Meisterschulen-am-Ostbahnhof-Munchen/JC8012P4A1C_I_W_Y_CAN/pcbs/keypad/docs/folika_keypad_12.pdf

# Tastatur 2 x 6 - PU-Folie + 3 mm Plexiglas (PG)

für JC8012P4A1C_I_W_Y_CAN, Variante mit Tastatur - gleiches Prinzip wie FO SON PU 005 HOEPFINGER (4 Taster)

Maßstab 1:1 auf A4 (ohne Skalierung drucken), Maße in mm, Ansicht von vorne.
Kontur 48 x 150 mm, Eckradius 1,5 mm - Folie, Plexiglas und Platine haben dieselbe Kontur.
PU-Folie: bedruckt, Rückseite 3M 468MP, Klebefreiheit in den Tastenfeldern (14 x 14 mm), keine Löcher.
Plexiglasplatte 3 mm: Rückseite 3M 300LSE (dicker!), wird auf die Platine geklebt.
Ausschnitte im PG: 12 x 16,3 x 16,3 mm für die Taster (Taster 12 mm, vergrößert wg. Lötfahnen), mit Nase 5,8 x 1,45 mm (Diode),
4 x Ø 6,6 mm für die M2,5-SMD-Abstandshülsen der Platine (von der Folie verdeckt). Tastenraster 24 mm (Spalten) x 22,56 mm (Reihen). Gesamtdicke 5,5 mm (flacher Teil).
Druck wie FO SON PU 005: grauer Grund (2 mm Beschnitt), Tastenfelder 14 mm farbig mit 2 mm grauem Rahmen, Arial Bold schwarz. Tastennummern F1-F12 wie beim CCI 60: F1-F6 rechte Spalte, F7-F12 linke Spalte (neben dem Display), von oben nach unten.

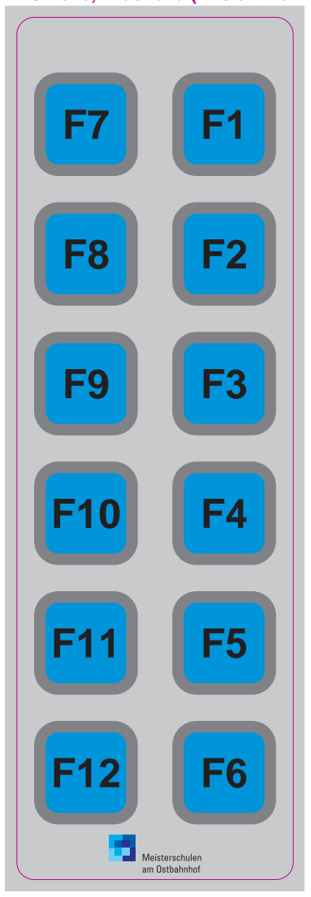
[picture p17: figure]

PU-Folie, Druckbild (Ansicht von vorne) | Plexiglas 3 mm (Ansicht von vorne)

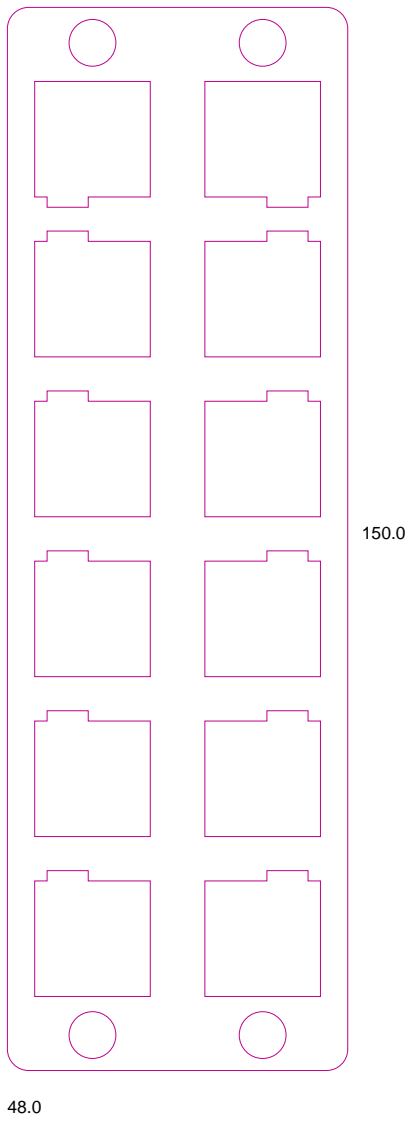
[picture p18: figure]

Mitten der Ausschnitte ab Tastaturmitte: x = ±12,0, y = ±11,28, ±33,84, ±56,40; Löcher Hülsen x = ±12,0, y = ±70,0
Nasen: Mitte 3,5 mm neben Tastenmitte zum Außenrand, bis 9,6 mm ab Tastenmitte; oberste Reihe unten, sonst oben
DXF mit derselben Geometrie: folika_keypad_12.dxf (Layer FOIL_OUTLINE, FOIL_KEY_FIELD_14, PG_OUTLINE, PG_CUT_POCKET, PG_CUT_HOLE_6_6)
