Meisterschulen-am-Ostbahnhof-Munchen/JC8012P4A1C_I_W_Y_CAN/pcbs/backplate_keypad/docs/backplate_outside.png

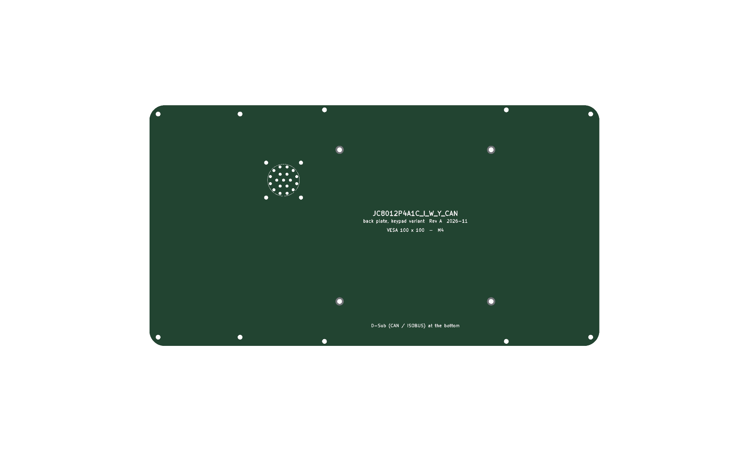
pcbs/backplate_keypad/docs/backplate_outside.png
