Meisterschulen-am-Ostbahnhof-Munchen/JC8012P4A1C_I_W_Y_CAN/pcbs/can_power/docs/board_3d_top.png

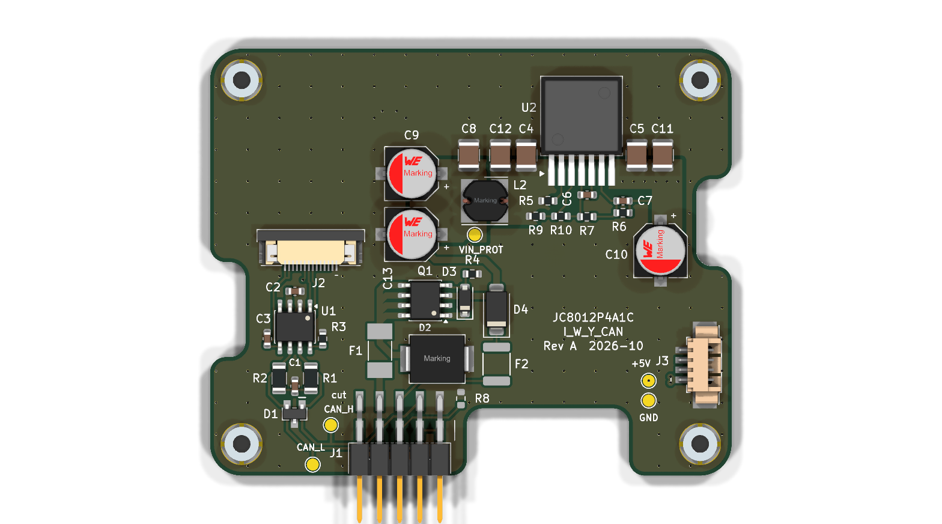
pcbs/can_power/docs/board_3d_top.png
