Meisterschulen-am-Ostbahnhof-Munchen/JC8012P4A1C_I_W_Y_CAN/mouser_order.csv

Mfr Part Number | Manufacturer | Qty per device | Order qty (5 devices + spares) | Description | Used for
MMSZ5245B_R1_00001 | Panjit | 1 | 6 | Zener diode 15 V SOD-123 | CAN board D3
B160-13-F | Diodes Incorporated | 1 | 6 | Schottky diode 60 V 1 A SMA | CAN board D4
0452001.MRL | Littelfuse | 1 | 6 | Fuse 1 A slow NANO2 | CAN board F1
MF-MSMF014-2 | Bourns | 1 | 6 | PTC fuse 0.14 A 60 V 1812 | CAN board F2
SI4948BEY-T1-E3 | Vishay | 1 | 6 | Dual P-MOSFET SO-8 | CAN board Q1
RC1206FR-07750RL | Yageo | 2 | 15 | Resistor 750 R 1 % 1206 | CAN board R1, R2
RC0603FR-0710KL | Yageo | 2 | 15 | Resistor 10 k 1 % 0603 | CAN board R3, R10
RC0603FR-07100KL | Yageo | 2 | 15 | Resistor 100 k 1 % 0603 | CAN board R4, R5
RC0603FR-075K62L | Yageo | 1 | 10 | Resistor 5k62 1 % 0603 | CAN board R6
RC0603FR-071K07L | Yageo | 1 | 10 | Resistor 1k07 1 % 0603 | CAN board R7
RC0603FR-0757K6L | Yageo | 1 | 10 | Resistor 57k6 1 % 0603 | CAN board R9
RC0603JR-070RL | Yageo | 0 | 10 | Resistor 0 R 0603 (optional) | CAN board R8, not fitted by default, only for harnesses that need TBC_GND
TLE9250VSJXUMA1 | Infineon | 1 | 6 | CAN transceiver SO-8 | CAN board U1
