Meisterschulen-am-Ostbahnhof-Munchen/JC8012P4A1C_I_W_Y_CAN/assembly_bom.csv

Pos | Qty | Part | Manufacturer | MPN | Note
1 | 4 | Screw M2x6 |  |  | addon board H1-H4 to display standoffs S1-S4, no washer (1.9 mm thread engagement in the 2.5 mm blind thread)
2 | 1 | FFC 14 pin, 0.5 mm pitch, 50 mm, type 2 (contacts on opposite sides) | Wurth Elektronik | 687714050002 | J2 to FPC3 EXTEND1 of the display board
3 | 1 | D-Sub 9 female, IDC for 1.27 mm ribbon cable, without nuts | Wurth Elektronik | 618009221923 | CAN cable, D-Sub side; from inside over the threads of the jackposts 7, fixed with the nuts 20. The shell is flush with the frame wall outside. Use the strain relief.
4 | 1 | IDC socket 2x5, 2.54 mm, with strain relief (WR-BHD) | Wurth Elektronik | 61201023021 | CAN cable, J1 side, position 10 closed with a coding plug
5 | 1 | Coding plug for IDC socket |  |  | closes position 10 (pin 10 of J1 is cut off)
6 | 1 | Ribbon cable 9 wire, 1.27 mm pitch, 28 AWG, 1 m piece | Wurth Elektronik | 63910915521CAB | CAN cable, length to be defined with the back plate; red wire = pin 1 on both ends, position 10 of the IDC socket stays empty (10 wire alternative: 63911015521CAB, then cut wire 10 short at the D-Sub)
7 | 2 | Jackpost (hex standoff) UNC 4-40 inner/outer, hex 5.0, thread 8.2, SW 4.5 (WA-HEX) | Wurth Elektronik | 94513200 | from outside into the 5 mm hex pockets of the frame wall, flush with the wall (1.0 mm wall under the hex). Glue them in with 2K epoxy (e.g. UHU plus endfest) on the side walls of the pocket only, not on the bottom (stays flush) and not into the female thread (screw a 4-40 screw in as a plug, wipe off at once); let it cure before the nuts 20 go on, then the bond takes most of the preload off the thin wall; takes the thumbscrews of the mating plug. Clamped length 4.76 mm (wall 1.0 + D-Sub flange 0.4 + body 3.0 + rivet collar 0.36), 3.4 mm of the thread in the nut 20. 94510000 (thread 5.0) and 94511000 (6.0) are too short.
8 | 8 | Thread forming screw for thermoplastics, WUEPLAST WN 1451, 3x10, pan head with flange (dk 6 mm), TX10 | Wurth | 4234 3 10 | back plate H5-H12 into the 2.4 mm pilot holes of the frame bosses (8.4 mm engagement)
9 | 6 | Screw M2.5x6 (original frame: M2.5x8) |  |  | frame to the brass posts of the display; with x6 only about 2 mm thread engagement unless the frame lugs get a counterbore
10 | 4 | Screw M4x12 |  |  | VESA 100 bracket to the M4 spacers of the back plate (bracket 1-3 mm thick)
11 | 2 | WR-WTB crimp housing 1.25 mm, 4 pin (female) | Wurth Elektronik | 653004113322 | 5 V cable: one on J3 of the addon board, one on CN2 of the display board
12 | 2 | WR-WTB pre-crimped wire 1.25 mm, contacts on both ends | Wurth Elektronik | 653153128130 | 5 V cable: one wire for pin 1 (+5V), one for pin 4 (GND), into the housings of pos. 11; 653100130115 does not fit (contact on one end only)
13 | 1 | Speaker 4 Ohm 3 W, 27.5 x 27.5 x 13 mm, cable 120 mm with 2-pin 1.25 mm plug |  | XHXDZ-2828 | LS1 on the inside of the back plate, membrane against the sound holes; plug into CN3 of the display board (top left corner seen from behind), cable through the opening of the display cover
14 | 4 | Screw M2.5x8 |  |  | speaker to the back plate, head outside; length depends on the thickness of the speaker lugs (to be measured)
15 | 4 | Nut M2.5 |  |  | speaker screws, inside
16 | 4 | Screw M2.5x8 |  |  | keypad variant only: keypad H1-H4 from behind through the 4 mm frame lugs and the PCB into the M2.5 spacers (2.4 mm thread). Never longer: an M2.5x10 pushes through the foil.
17 | 2 | Thread forming screw for thermoplastics, WUEPLAST WN 1451, 3x10 | Wurth | 4234 3 10 | keypad variant only: back plate H13/H14 in the corners of the keypad chamber (in addition to pos. 8)
18 | 1 | FFC 14 pin, 0.5 mm pitch, about 250 mm, type TBD | Wurth Elektronik |  | keypad variant only: keypad J1 to FPC4 EXTEND2 of the display board; length and type (contacts on the same / opposite sides) to be checked on the test print, pin 1 must end on pin 1
19 | 1 | PU foil printed + 3 mm plexiglass, 48 x 150 mm | Folika |  | keypad variant only: as FO SON PU 005 HOEPFINGER, drawing keypad/docs/folika_keypad_12.pdf
20 | 2 | Hex nut UNC 4-40, SW 4.5, 5 mm high (WA-HEX) | Wurth Elektronik | 94505009 | from inside onto the jackposts 7, clamps the D-Sub 3. Tighten only lightly (about 0.1 Nm): the 1.0 mm plastic wall under the jackpost hex takes the preload. Secure with locking lacquer (e.g. Loctite 7400) over nut and thread end, no liquid threadlocker (Loctite 2xx attacks ABS). Tighten with a socket SW 4.5 before the IDC cover and the strain relief are on, they are in the way of the socket; afterwards only an open-end wrench SW 4.5 fits)
