Meisterschulen-am-Ostbahnhof-Munchen/JC8012P4A1C_I_W_Y_CAN/pcbs/can_power/production/JC8012P4A1C_I_W_Y_CAN_bom.csv

Reference | Qty | Value | Manufacturer | MPN | Footprint | DNP
C1 | 1 | 47n | Wurth Elektronik | 885012206093 | Capacitor_SMD:C_0603_1608Metric
C2,C3 | 2 | 100n | Wurth Elektronik | 885012206095 | Capacitor_SMD:C_0603_1608Metric
C4,C12 | 2 | 10u/50V | Wurth Elektronik | 885012209073 | Capacitor_SMD:C_1210_3225Metric
C5,C11 | 2 | 47u/10V | Wurth Elektronik | 885012109007 | Capacitor_SMD:C_1210_3225Metric
C6,C7 | 2 | 22n | Wurth Elektronik | 885012206091 | Capacitor_SMD:C_0603_1608Metric
C8 | 1 | 1u/50V | Wurth Elektronik | 885012209047 | Capacitor_SMD:C_1210_3225Metric
C9,C13 | 2 | 22u/50V | Wurth Elektronik | 865080643008 | JC8012P4A1C_CAN:CP_Wurth_WCAP-ASLI-D6.3L5.5
C10 | 1 | 220u/10V | Wurth Elektronik | 875105244013 | JC8012P4A1C_CAN:CP_Wurth_WCAP-PSLP-D6.3L5.8
D1 | 1 | 824094024 | Wurth Elektronik | 824094024 | JC8012P4A1C_CAN:D_Wurth_WE-TVS-SOT23-3L
D2 | 1 | 824551241 | Wurth Elektronik | 824551241 | JC8012P4A1C_CAN:D_Wurth_WE-TVSP-DO214-AB-3000W_BI
D3 | 1 | 15V | Panjit | MMSZ5245B_R1_00001 | Diode_SMD:D_SOD-123
D4 | 1 | B160 | Diodes Incorporated | B160-13-F | Diode_SMD:D_SMA
F1 | 1 | 1A slow 125V | Littelfuse | 0452001.MRL | Fuse:Fuse_Littelfuse-NANO2-451_453
F2 | 1 | PTC 0.14A/60V | Bourns | MF-MSMF014-2 | Fuse:Fuse_1812_4532Metric
H1-H4 | 4 | Spacer M2 L2.5 | Wurth Elektronik | 9774025943R | JC8012P4A1C_CAN:A_Wurth_WA-SMST_9774025943R
J1 | 1 | 610110249121 | Wurth Elektronik | 610110249121 | JC8012P4A1C_CAN:J_Wurth_WR-PHD_610110249121
J2 | 1 | 68711414522 | Wurth Elektronik | 68711414522 | JC8012P4A1C_CAN:J_Wurth_WR-FPC_68711414522
J3 | 1 | 653104131822 | Wurth Elektronik | 653104131822 | JC8012P4A1C_CAN:J_Wurth_WR-WTB_653104131822
L2 | 1 | 10uH | Wurth Elektronik | 74477410 | JC8012P4A1C_CAN:L_Wurth_WE-PD2-5848
Q1 | 1 | Si4948BEY | Vishay | SI4948BEY-T1-E3 | Package_SO:SOIC-8_3.9x4.9mm_P1.27mm
R1,R2 | 2 | 750 1% | Yageo | RC1206FR-07750RL | Resistor_SMD:R_1206_3216Metric
R3,R10 | 2 | 10k 1% | Yageo | RC0603FR-0710KL | Resistor_SMD:R_0603_1608Metric
R4,R5 | 2 | 100k 1% | Yageo | RC0603FR-07100KL | Resistor_SMD:R_0603_1608Metric
R6 | 1 | 5k62 1% | Yageo | RC0603FR-075K62L | Resistor_SMD:R_0603_1608Metric
R7 | 1 | 1k07 1% | Yageo | RC0603FR-071K07L | Resistor_SMD:R_0603_1608Metric
R8 | 1 | 0R DNP | Yageo | RC0603JR-070RL | Resistor_SMD:R_0603_1608Metric | Nicht bestücken
R9 | 1 | 57k6 1% | Yageo | RC0603FR-0757K6L | Resistor_SMD:R_0603_1608Metric
U1 | 1 | TLE9250VSJ | Infineon | TLE9250VSJXUMA1 | Package_SO:SOIC-8_3.9x4.9mm_P1.27mm
U2 | 1 | 171030601 | Wurth Elektronik | 171030601 | JC8012P4A1C_CAN:U_Wurth_WPME-VDRM-TO263-7EP
