Meisterschulen-am-Ostbahnhof-Munchen/JC8012P4A1C_I_W_Y_CAN/pcbs/keypad/production/JC8012P4A1C_keypad_bom.csv

Reference | Qty | Value | Manufacturer | MPN | Footprint | DNP
D1-D12 | 12 | BAT43W | Panjit | BAT43W_R1_00001 | Diode_SMD:D_SOD-123
H1-H4 | 4 | Spacer M2.5 L3 | Wurth Elektronik | 9774030151R | Keypad:A_Wurth_WA-SMSI_9774030151R
J1 | 1 | 68711414522 | Wurth Elektronik | 68711414522 | Keypad:J_Wurth_WR-FPC_68711414522
S1-S12 | 12 | 430162043826 | Wurth Elektronik | 430162043826 | Keypad:SW_Wurth_WS-TASV_430162043826
