Meisterschulen-am-Ostbahnhof-Munchen/JC8012P4A1C_I_W_Y_CAN/pcbs/backplate/production/JC8012P4A1C_backplate_bom.csv

Reference | Qty | Value | Manufacturer | MPN | Footprint | DNP
H1-H4 | 4 | Spacer M4 L10 | Wurth Elektronik | 9774100482R | Backplate:A_Wurth_WA-SMSI_9774100482R
