Meisterschulen-am-Ostbahnhof-Munchen/JC8012P4A1C_I_W_Y_CAN/assembly/JC8012P4A1C_assembly_variant2_keypad.step

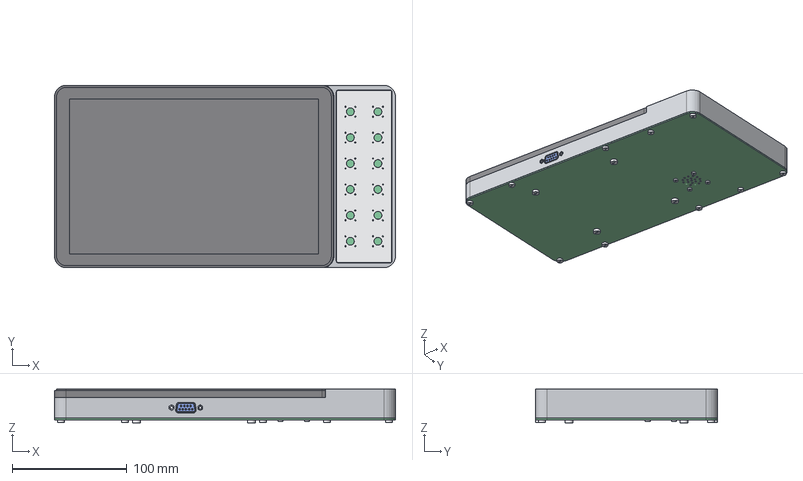
[picture p23: CAD file, 2026-11-13]
assembly/JC8012P4A1C_assembly_variant2_keypad.step
296.9 x 158.7 x 29.2 mm
A Display Guition JC8012P4A1C (envelope)
C Frame with keypad chamber
3 D-Sub 9 female (618009221923)
7 Jackpost (94513200)
20 Hex nut UNC 4-40 (94505009)
9 Screw M2.5x6
D Back plate PCB
13 Speaker 4 Ohm 3 W (XHXDZ-2828)
15 Nut M2.5
14 Screw M2.5x8
8 Thread forming screw for thermoplastics (4234 3 10)
10 Screw M4x12
B CAN addon board
1 Screw M2x6
E Keypad PCB
19 PU foil printed + 3 mm plexiglass
19 PU foil, printed (Folika)
16 Screw M2.5x8
17 Thread forming screw for thermoplastics (4234 3 10)
