Meisterschulen-am-Ostbahnhof-Munchen/JC8012P4A1C_I_W_Y_CAN/assembly/models/D-Sub_Wurth_618009221923.step

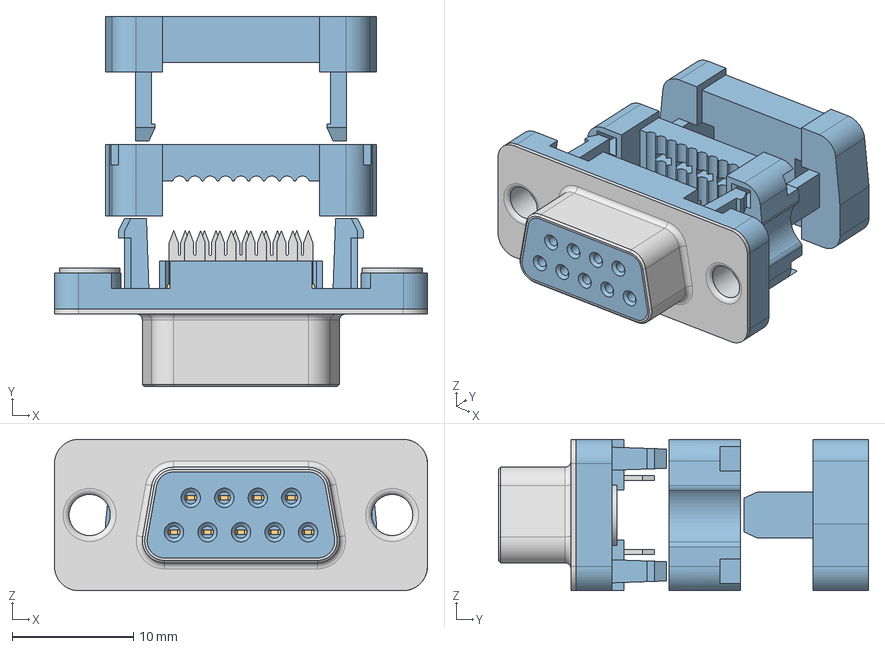
[picture p24: CAD file, 2026-11-13]
assembly/models/D-Sub_Wurth_618009221923.step
30.8 x 30.6 x 12.5 mm
6180xx221923_PIN
6180xx221923_PIN02
6180xx221923_PIN04
61800922x923_Pad
6180xx221923_PIN05
6180xx221923_Rivet x 2
6180xx221923_PIN03
6180xx221923_PIN20
6180xx221923_PIN21
6180xx221923_PIN22
6180xx221923_PIN23
61800922x923_Strain Relief
