Meisterschulen-am-Ostbahnhof-Munchen/JC8012P4A1C_I_W_Y_CAN/mechanics/frame.step

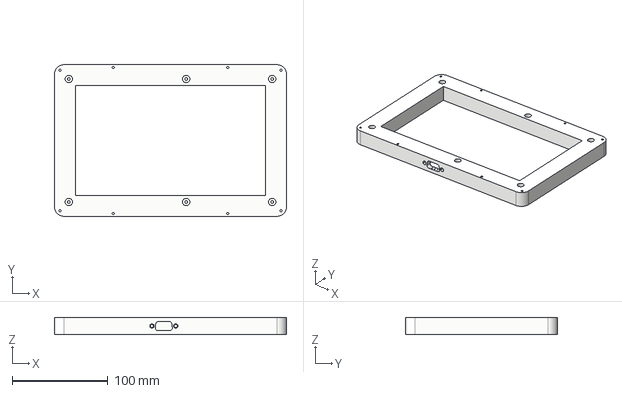
[picture p25: CAD file, 2026-11-13]
mechanics/frame.step
242.8 x 158.7 x 18.0 mm
