Meisterschulen-am-Ostbahnhof-Munchen/JC8012P4A1C_I_W_Y_CAN/mechanics/source/guition_mount-landscape.step

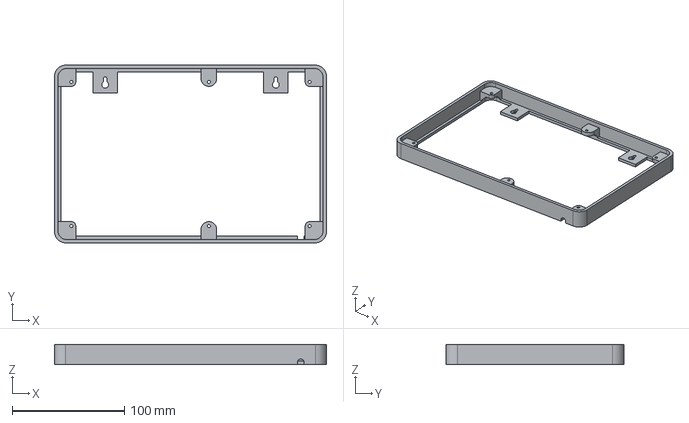
[picture p26: CAD file, 2026-11-01]
mechanics/source/guition_mount-landscape.step
242.8 x 158.7 x 18.0 mm
