Meisterschulen-am-Ostbahnhof-Munchen/JC8012P4A1C_I_W_Y_CAN/pcbs/keypad/docs/folika_keypad_12.dxf

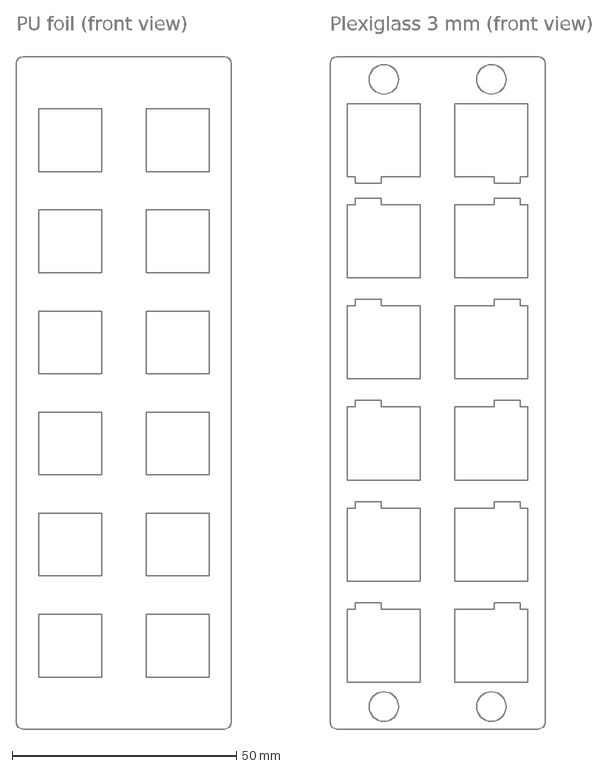
[picture p27: CAD file, 2026-11-03]
pcbs/keypad/docs/folika_keypad_12.dxf
PU foil (front view)
Plexiglass 3 mm (front view)
