Meisterschulen-am-Ostbahnhof-Munchen/JC8012P4A1C_I_W_Y_CAN/assembly/models/HexNut_Wurth_94505009.step

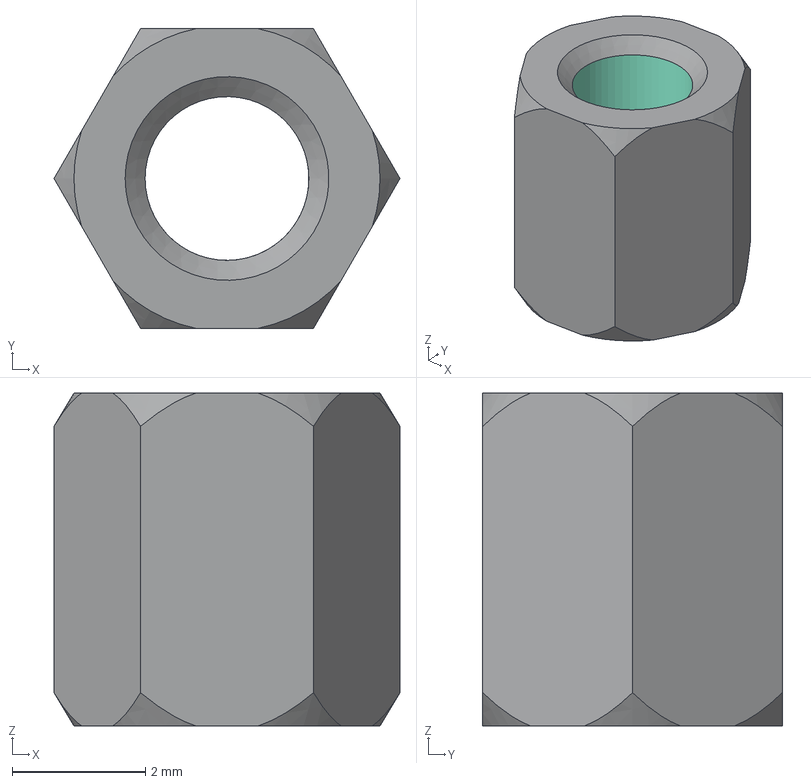
[picture p28: CAD file, 2026-11-13]
assembly/models/HexNut_Wurth_94505009.step
5.20 x 4.50 x 5.00 mm
