Meisterschulen-am-Ostbahnhof-Munchen/JC8012P4A1C_I_W_Y_CAN/mechanics/frame_keypad.step

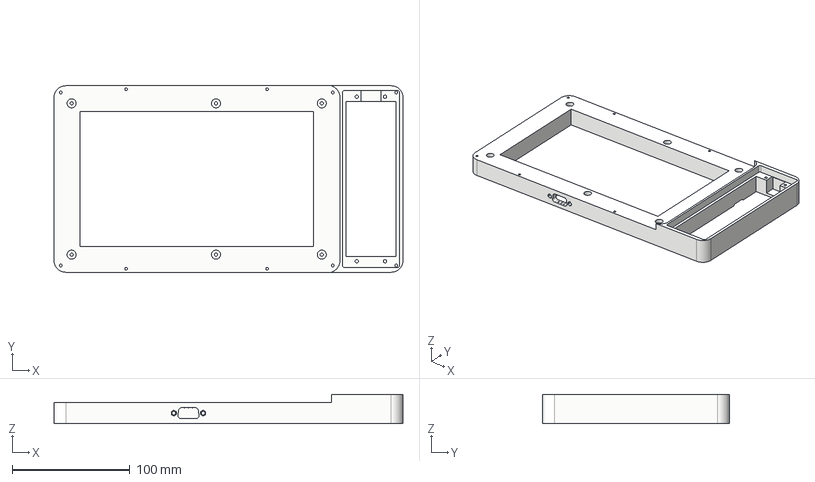
[picture p29: CAD file, 2026-11-13]
mechanics/frame_keypad.step
296.9 x 158.7 x 25.0 mm
