Meisterschulen-am-Ostbahnhof-Munchen/JC8012P4A1C_I_W_Y_CAN/assembly/models/Jackpost_Wurth_94513200.step

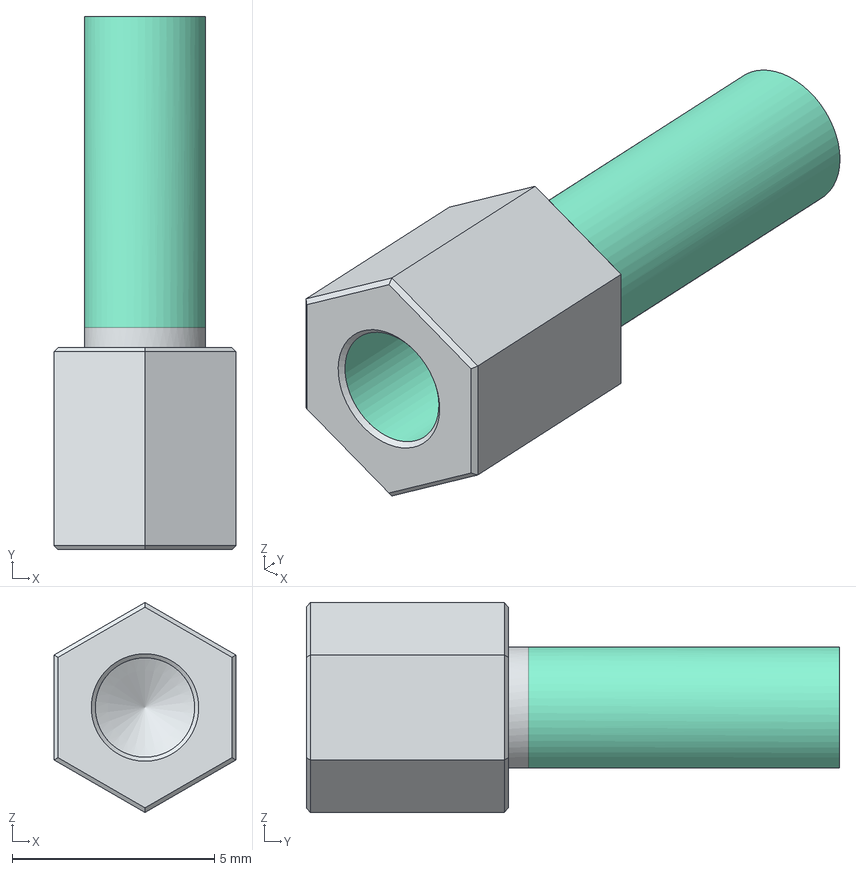
[picture p30: CAD file, 2026-11-13]
assembly/models/Jackpost_Wurth_94513200.step
4.50 x 13.2 x 5.20 mm
