Meisterschulen-am-Ostbahnhof-Munchen/JC8012P4A1C_I_W_Y_CAN/assembly/models/Jackpost_Wurth_94510000.step

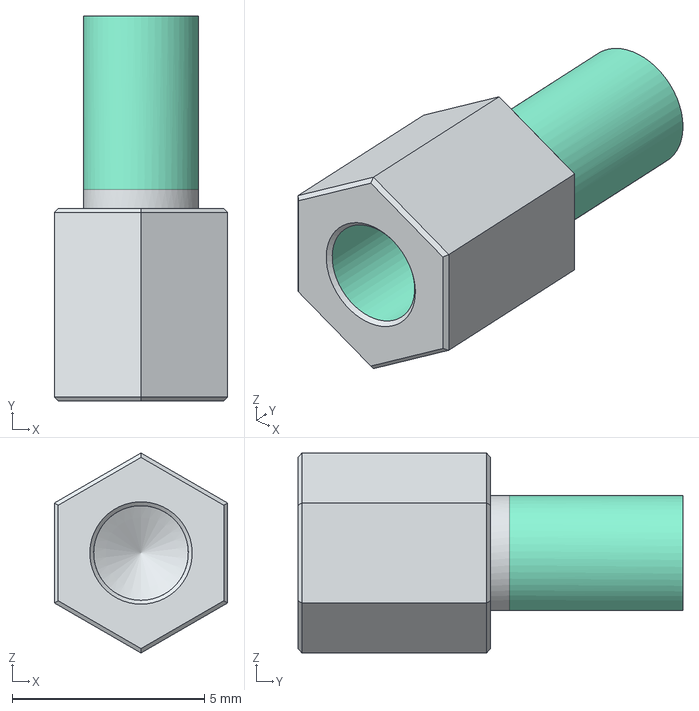
[picture p31: CAD file, 2026-11-03]
assembly/models/Jackpost_Wurth_94510000.step
4.50 x 10.0 x 5.20 mm
