Meisterschulen-am-Ostbahnhof-Munchen/JC8012P4A1C_I_W_Y_CAN/assembly/models/JC8012P4A1_envelope.step

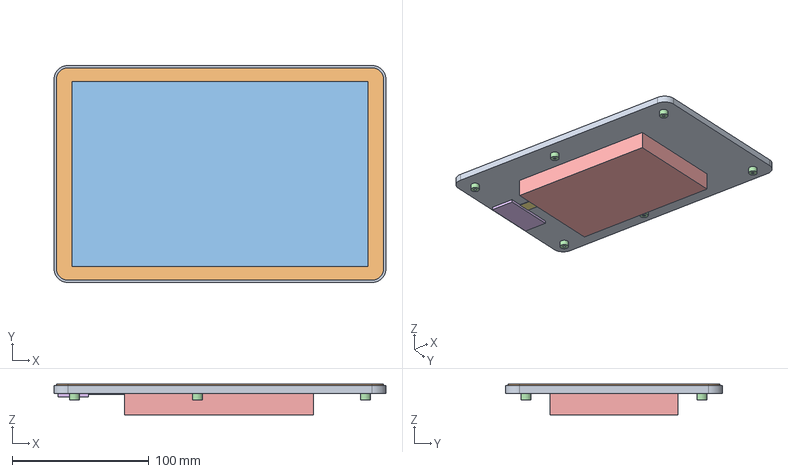
[picture p32: CAD file, 2026-11-03]
assembly/models/JC8012P4A1_envelope.step
242.8 x 158.7 x 22.5 mm
Frame
CoverGlass
LCD_ActiveArea
Bosses
BackHousing
ConnectorBlock
FlatCable
