Meisterschulen-am-Ostbahnhof-Munchen/JC8012P4A1C_I_W_Y_CAN/(list of files, cad)

Other CAD files:
mechanics/frame.f3d
mechanics/frame.stl
mechanics/frame_keypad.f3d
mechanics/frame_keypad.stl
