Meisterschulen-am-Ostbahnhof-Munchen/JC8012P4A1C_I_W_Y_CAN/assembly/img/variant1_assembled_front.png

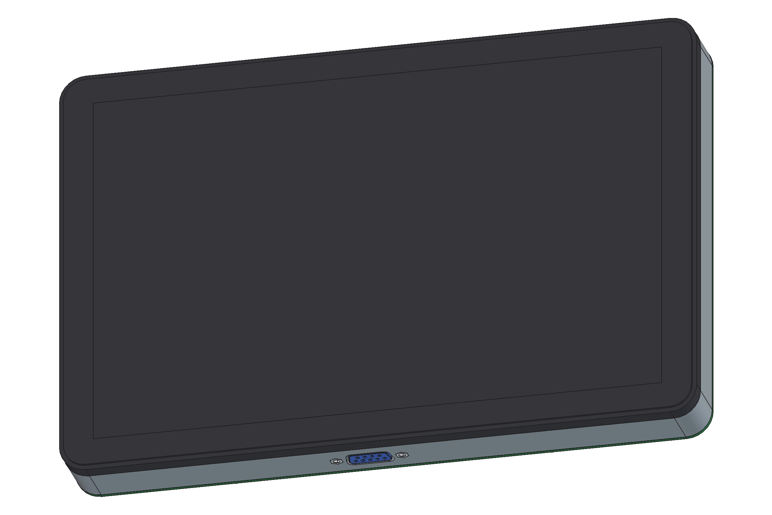
assembly/img/variant1_assembled_front.png
