Meisterschulen-am-Ostbahnhof-Munchen/JC8012P4A1C_I_W_Y_CAN/assembly/img/variant1_exploded_back.png

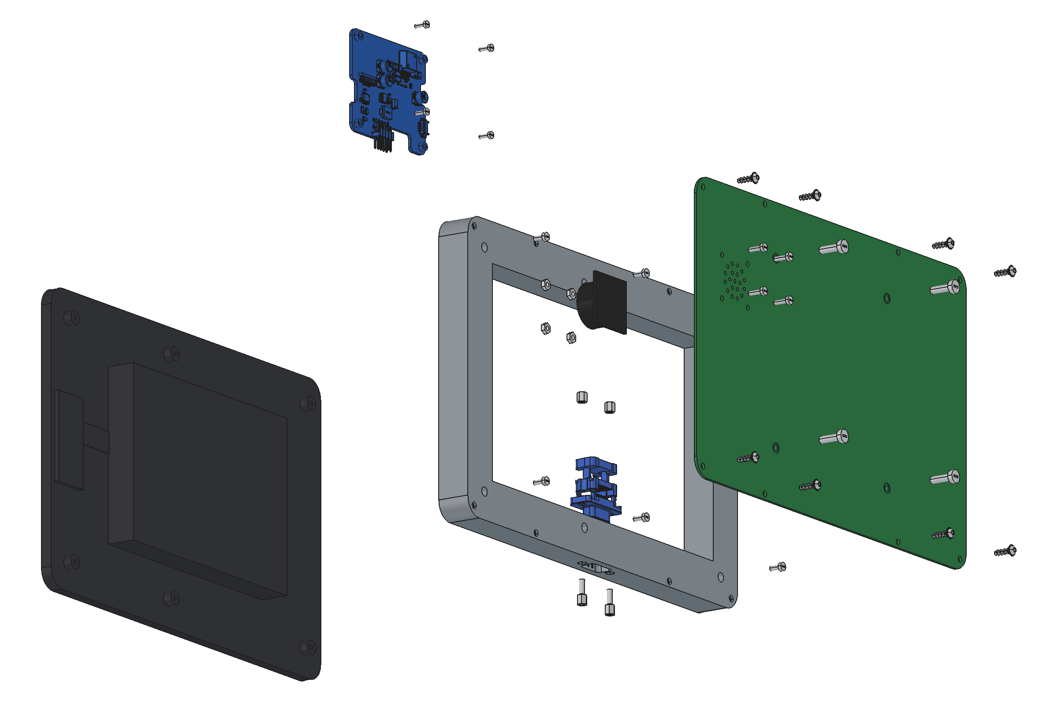
assembly/img/variant1_exploded_back.png
