Meisterschulen-am-Ostbahnhof-Munchen/JC8012P4A1C_I_W_Y_CAN/assembly/img/variant2_assembled_front.png

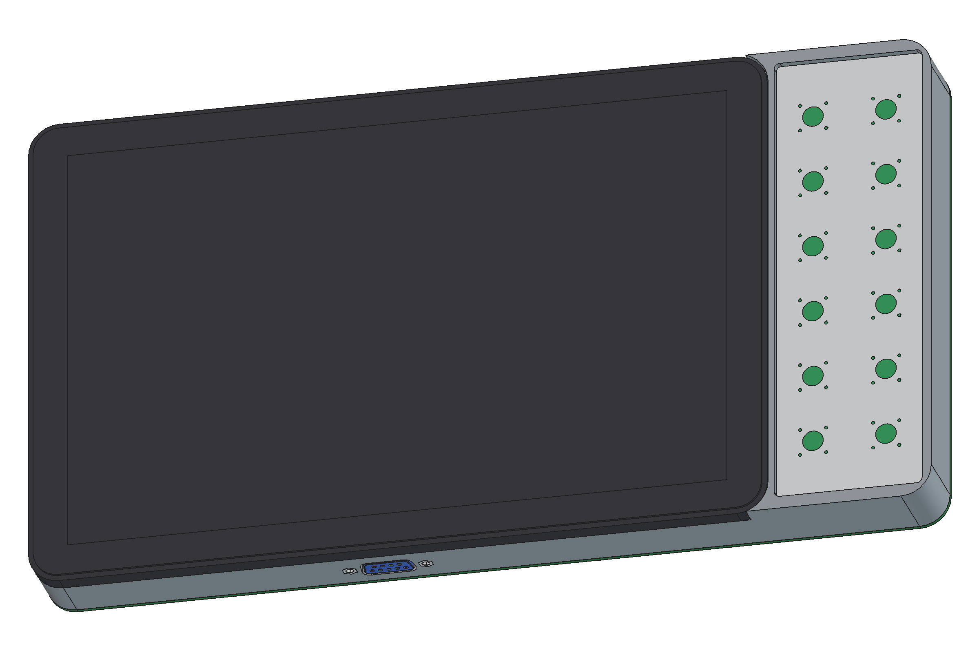
assembly/img/variant2_assembled_front.png
