Meisterschulen-am-Ostbahnhof-Munchen/JC8012P4A1C_I_W_Y_CAN/assembly/render/tex/screen.png

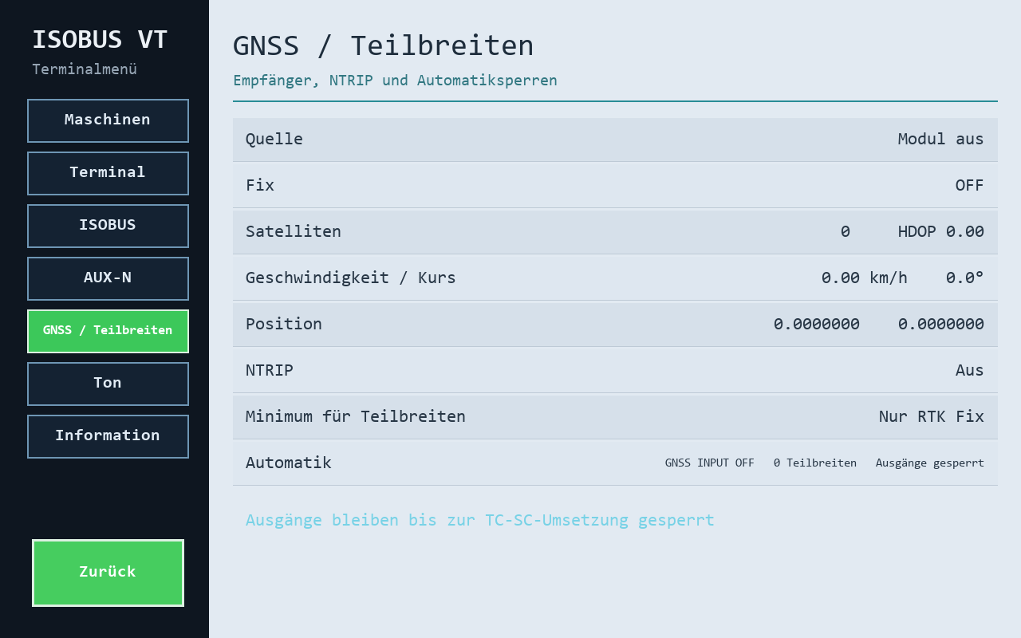
assembly/render/tex/screen.png
