Meisterschulen-am-Ostbahnhof-Munchen/JC8012P4A1C_I_W_Y_CAN/mechanics/docs/assembly_back.png

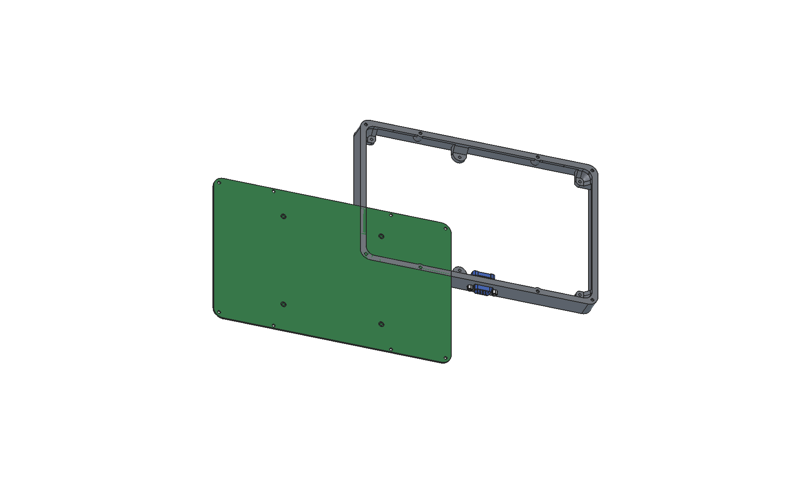
mechanics/docs/assembly_back.png
