Meisterschulen-am-Ostbahnhof-Munchen/JC8012P4A1C_I_W_Y_CAN/pcbs/backplate/docs/JC8012P4A1C_backplate_schematic.pdf

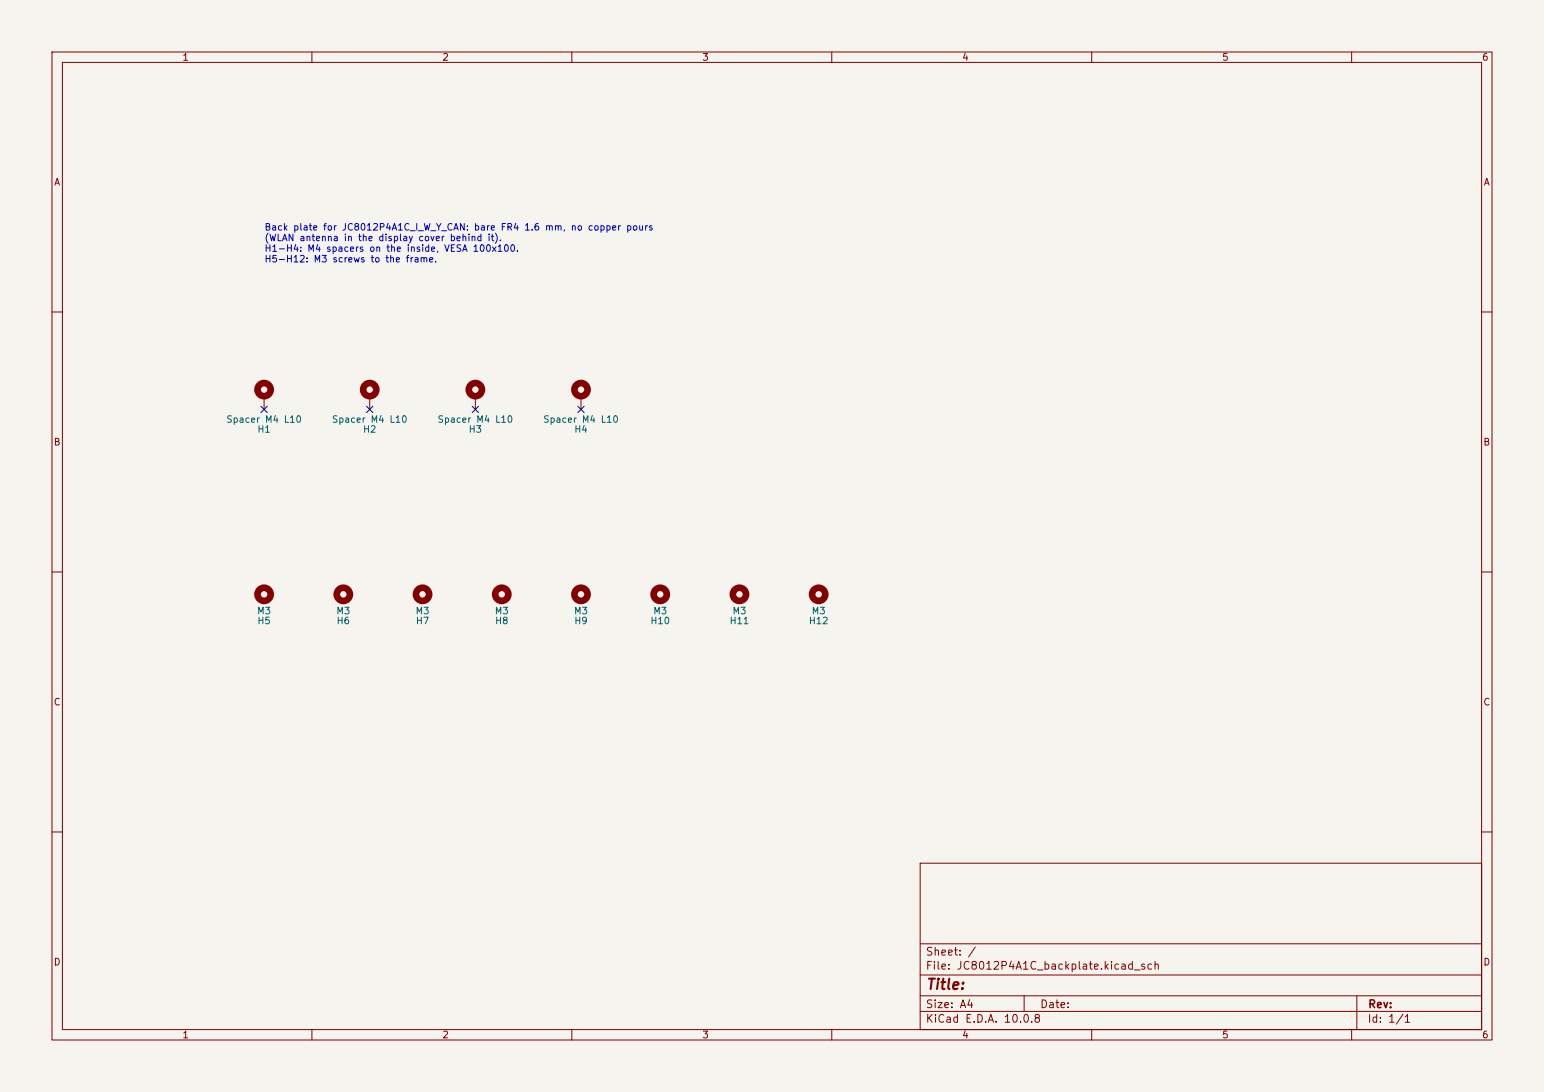
[picture p49: page 1]

(WLAN antenna in the display cover behind it). H1-H4: M4 spacers on the inside, VESA 100x100. H5-H12: M3 screws to the frame.

Size: A4 | Rev:
KiCad E.D.A. 10.0.8 | Id: 1/1
