Meisterschulen-am-Ostbahnhof-Munchen/JC8012P4A1C_I_W_Y_CAN/pcbs/backplate_keypad/docs/JC8012P4A1C_backplate_keypad_schematic.pdf

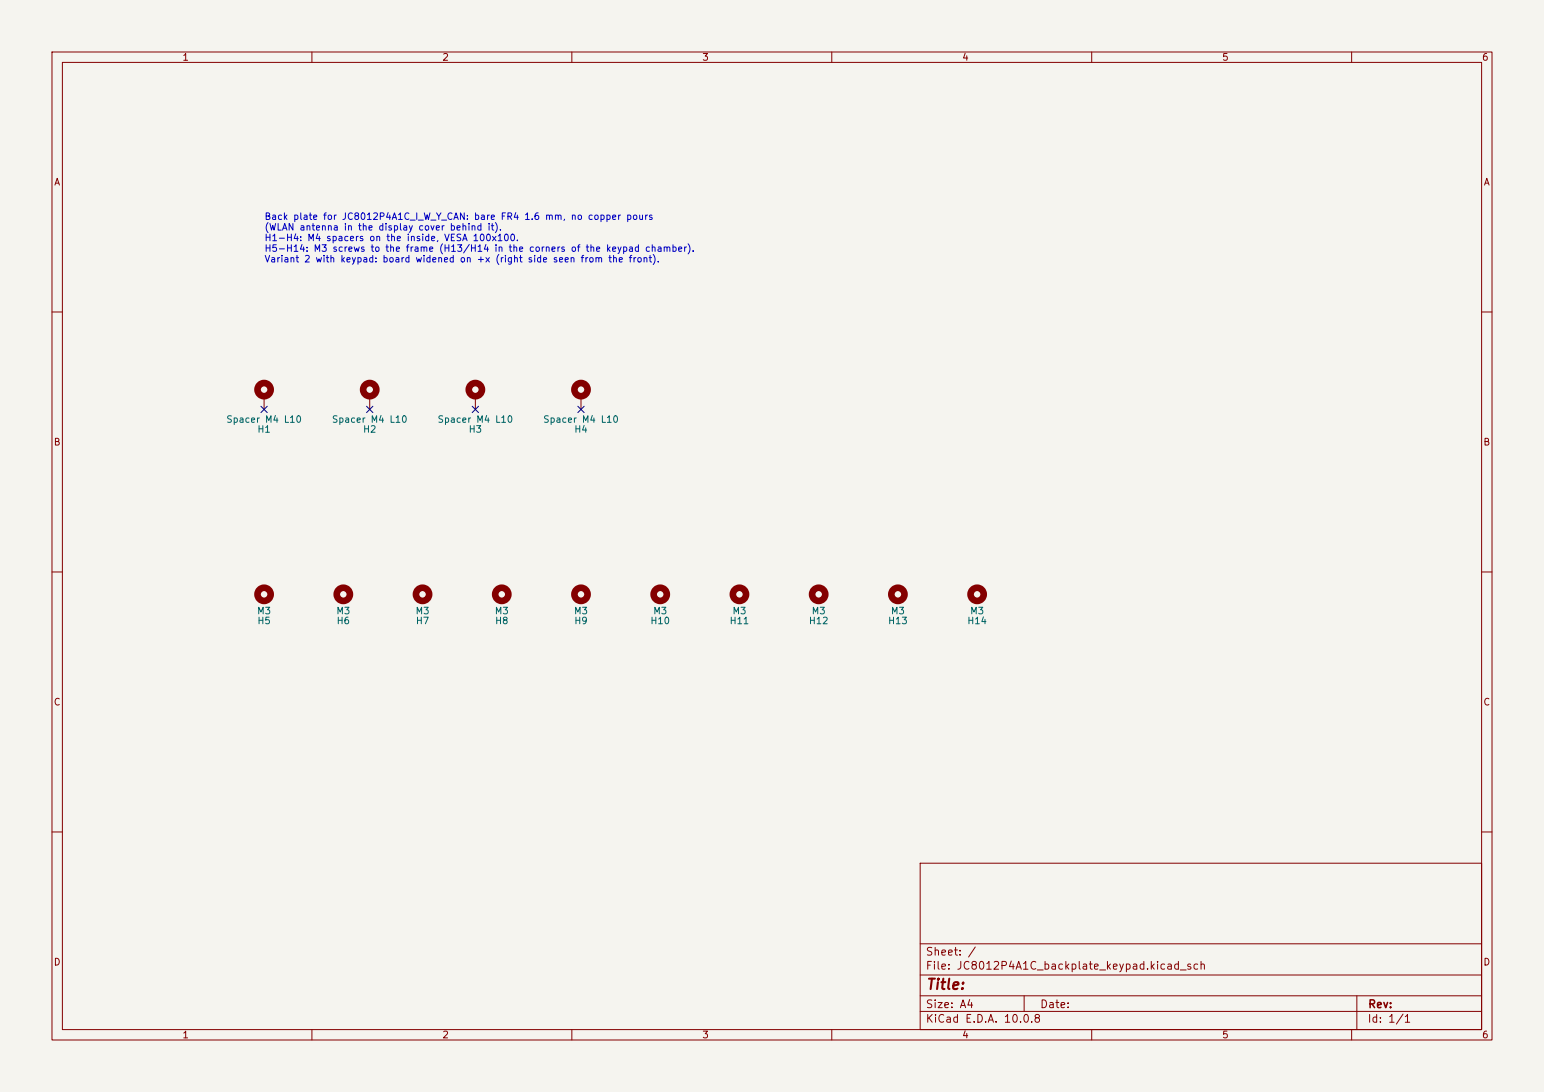
[picture p50: page 1]

Spacer M4 L10 Back plate for JC8012P4A1C_I_W_Y_CAN: bare FR4 1.6 mm, no copper pours

(WLAN antenna in the display cover behind it). H1-H4: M4 spacers on the inside, VESA 100x100. H5-H14: M3 screws to the frame (H13/H14 in the corners of the keypad chamber). Variant 2 with keypad: board widened on +x (right side seen from the front).

Size: A4 | Rev:
KiCad E.D.A. 10.0.8 | Id: 1/1
