Meisterschulen-am-Ostbahnhof-Munchen/JC8012P4A1C_I_W_Y_CAN/pcbs/can_power/docs/JC8012P4A1C_I_W_Y_CAN_schematic.pdf

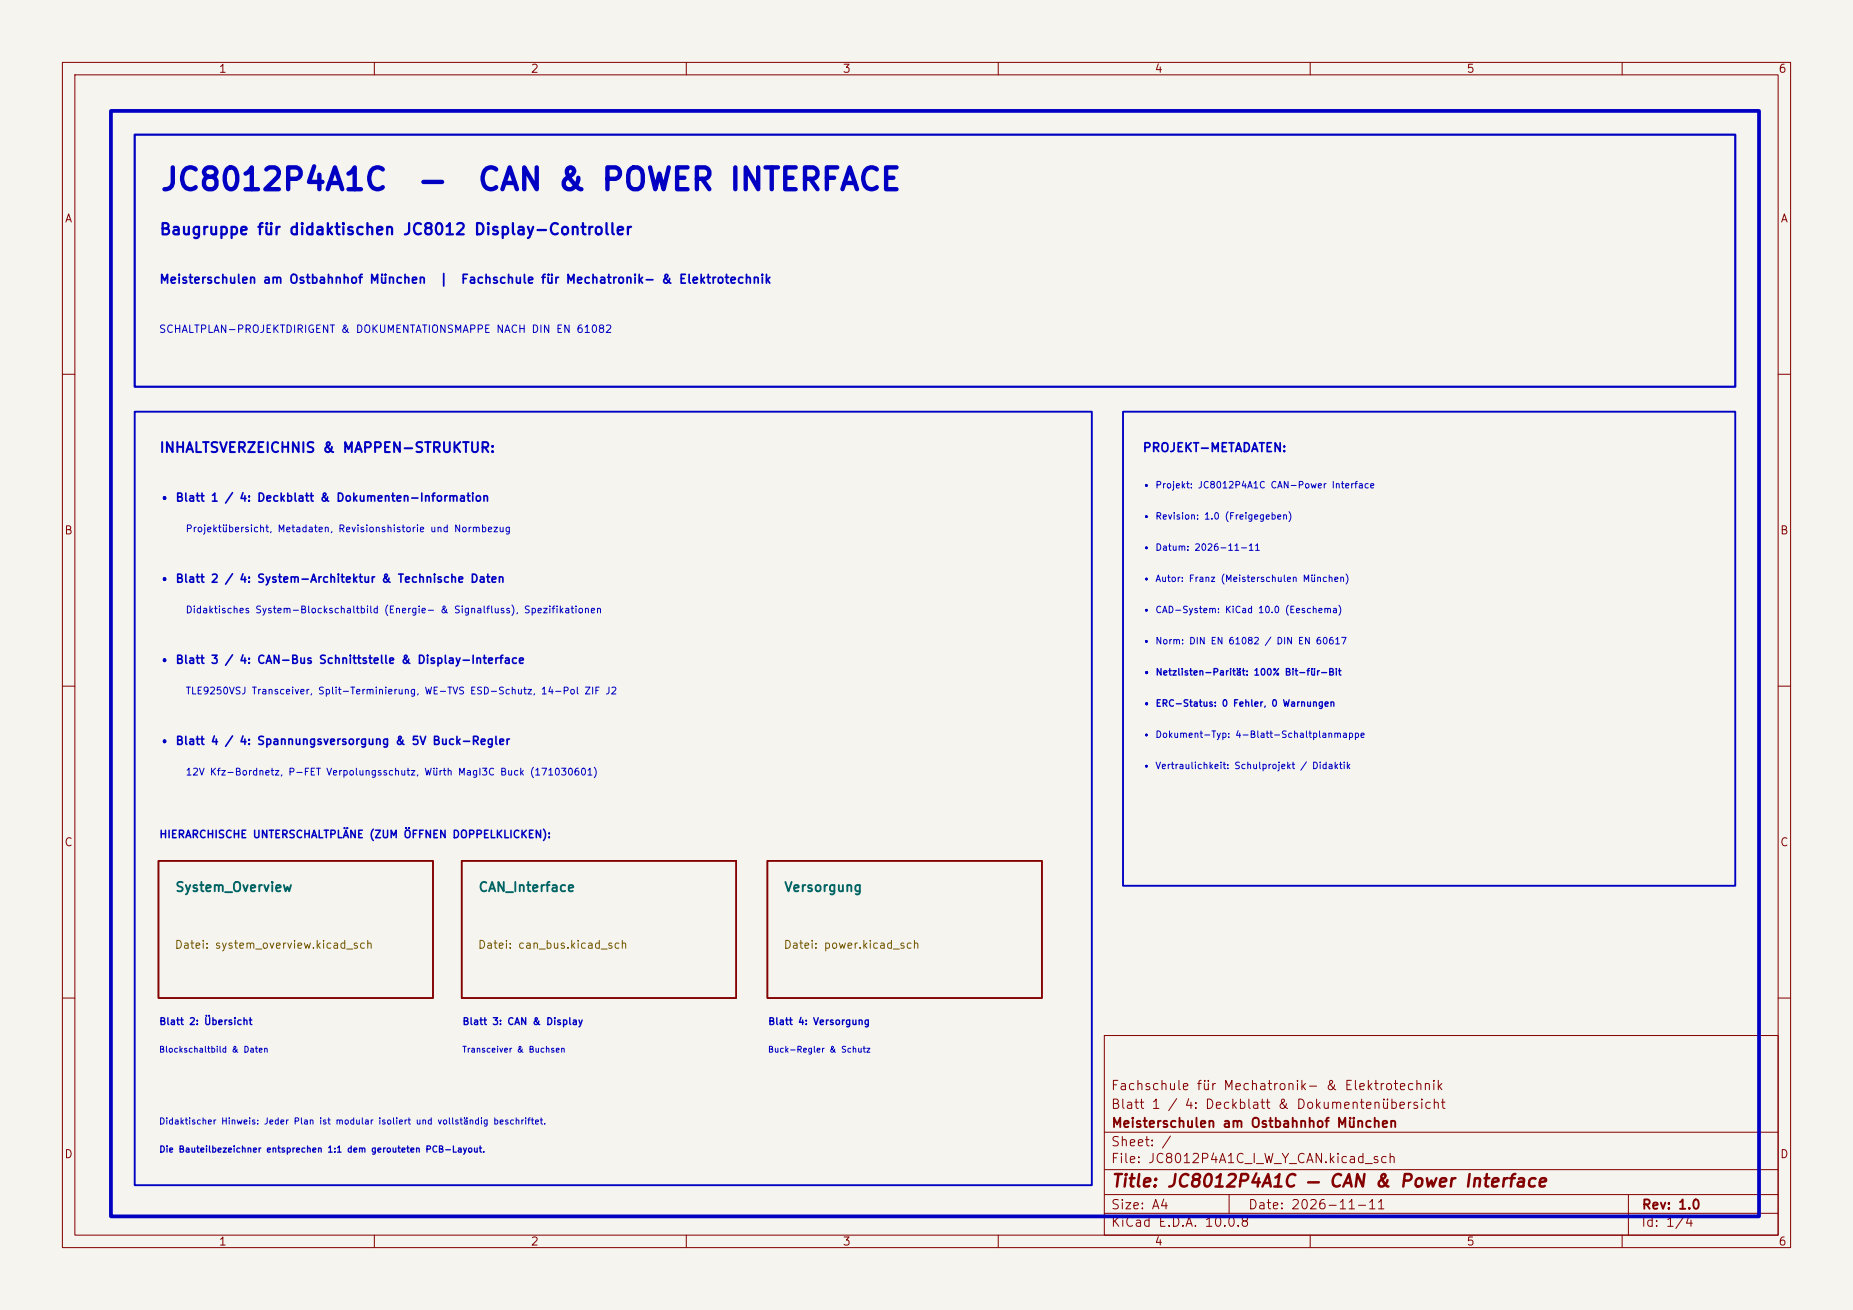
[picture p51: page 1]

Datei: can_bus.kicad_sch JC8012P4A1C — CAN & POWER INTERFACE

Baugruppe für didaktischen JC8012 Display-Controller

Meisterschulen am Ostbahnhof München | Fachschule für Mechatronik- & Elektrotechnik

INHALTSVERZEICHNIS & MAPPEN-STRUKTUR: SCHALTPLAN-PROJEKTDIRIGENT & DOKUMENTATIONSMAPPE NACH DIN EN 61082

PROJEKT-METADATEN: • Datum: 2026-11-11 • Vertraulichkeit: Schulprojekt / Didaktik • Autor: Franz (Meisterschulen München) • Projekt: JC8012P4A1C CAN-Power Interface

Projektübersicht, Metadaten, Revisionshistorie und Normbezug 12V Kfz-Bordnetz, P-FET Verpolungsschutz, Würth MagI3C Buck (171030601) • Blatt 1 / 4: Deckblatt & Dokumenten-Information

Didaktischer Hinweis: Jeder Plan ist modular isoliert und vollständig beschriftet. HIERARCHISCHE UNTERSCHALTPLÄNE (ZUM ÖFFNEN DOPPELKLICKEN): Didaktisches System-Blockschaltbild (Energie- & Signalfluss), Spezifikationen • Blatt 3 / 4: CAN-Bus Schnittstelle & Display-Interface • Blatt 4 / 4: Spannungsversorgung & 5V Buck-Regler • Blatt 2 / 4: System-Architektur & Technische Daten

TLE9250VSJ Transceiver, Split-Terminierung, WE-TVS ESD-Schutz, 14-Pol ZIF J2

Fachschule für Mechatronik- & Elektrotechnik Blatt 1 / 4: Deckblatt & Dokumentenübersicht Meisterschulen am Ostbahnhof München

Die Bauteilbezeichner entsprechen 1:1 dem gerouteten PCB-Layout.

Sheet: / File: JC8012P4A1C_I_W_Y_CAN.kicad_sch | D Date: 2026-11-11
Title: JC8012P4A1C — CAN & Power Interface
Size: A4 | Rev: 1.0

AB

C

D

AB

C

Fachschule für Mechatronik- & Elektrotechnik Blatt 2 / 4: System-Blockschaltbild & Technische Daten Meisterschulen am Ostbahnhof München

Sheet: /System_Overview/ File: system_overview.kicad_sch | D Date: 2026-11-11

# Title: JC8012P4A1C — System-Architektur

# SYSTEM-BLOCKSCHALTBILD (SIGNAL- & ENERGIEFLUSS)

5. +5V Ausgangs-Rail Würth 171030601 (5V, max. 3A) Sternmasse BUCK_AGND 3. LC-Filterung | 4. MagI3C Buck-Regler | C10 220µF | C5, C11 47µF > | > | Speisung Transceiver & J3 (5V Display) Dual P-FET Q1 (Si4948) Zener D3 | TBC-Zweig 2. Verpolungsschutz <> | <>

Drossel L2 (10µH, 2.2A)
Pufferung C4, C12 • Dokumentations-Norm: DIN EN 61082 / DIN EN 60617 (100% Netzlisten-Identität)
Infineon CAN FD ready Transceiver (bis 5 Mbit/s) VCC = 5.0V Speisung | | | VIO = 3.3V Logikreferenz
Testpunkte TP1 (+5V), TP2 (GND), TP3/TP4 (Bus) Standby-Steuerung NEN über Pull-down R3 (10k) CAN-Transceiver U1 (TLE9250VSJ) Didaktische Architekturübersicht der Funktionsblöcke nach DIN EN 61082 — JC8012P4A1C 1. ENERGIEFLUSS: SPANNUNGSVERSORGUNG (Kfz-Bordnetz 12V -> 5V Systemspannung): 2. SIGNALFLUSS: KOMMUNIKATION & DISPLAY-SCHNITTSTELLE (CAN-Bus <-> CAN-Controller TWAI des Displays): | 14-Pol ZIF-FPC Flachbandkabel (0.5mm) Verbindung zum JC8012 Controller Signale: TXD, RXD, NEN, +3.3V, GND
TXD / RXD / NEN | Direkte Einspeisung der VIO-Referenz Display-Interface J2 • Eingangsspannung: 12 V Kfz-Bordnetz (ECU_PWR), Buck-Modul selbst 6 ... 42 V TECHNISCHE DATEN & BETRIEBSPARAMETER: • EMV / Filterung: Würth WE-TVS D1 (38 pF), Split-Termination R1/R2/C1 • CAN-Transceiver: Infineon TLE9250VSJ (ISO 11898-2:2016, bis 5 Mbit/s CAN FD) • Logikpegel: 3.3 V LVCMOS (VIO direkt über Display-Interface J2 gespeist) • Ausgangsspannung U_OUT: 5.0 V DC (Würth MagI3C 171030601, Modul max. 3 A)
1. Einspeisung | >

CAN-Bus Interface (J1) 10-Pol Pin-Header J1

ESD-Schutzdiode D1 (WE-TVS) Split-Termination R1/R2 je 750 Ohm, C1 47nF

TBC-Ausgang über D4/F2 (D-Sub Pin 8) • Schutzbeschaltung: TVS 24V D2 (SMDJ24CA, Klemmung max. 38.9 V), Dual P-FET Q1 (Si4948), 1A Sicherung F1 • Layout-Vorgabe: Separate analoge Sternmasse BUCK_AGND (R7, R10, C6) • TBC-Ausgang: D-Sub Pin 8 (TBC_PWR_OUT) über Schottky-Diode D4 (B160) und PTC F2 (0.14A)

ECU_PWR_IN (12V) F1 1A | TVS 24V D2
CAN_H / CAN_L | >

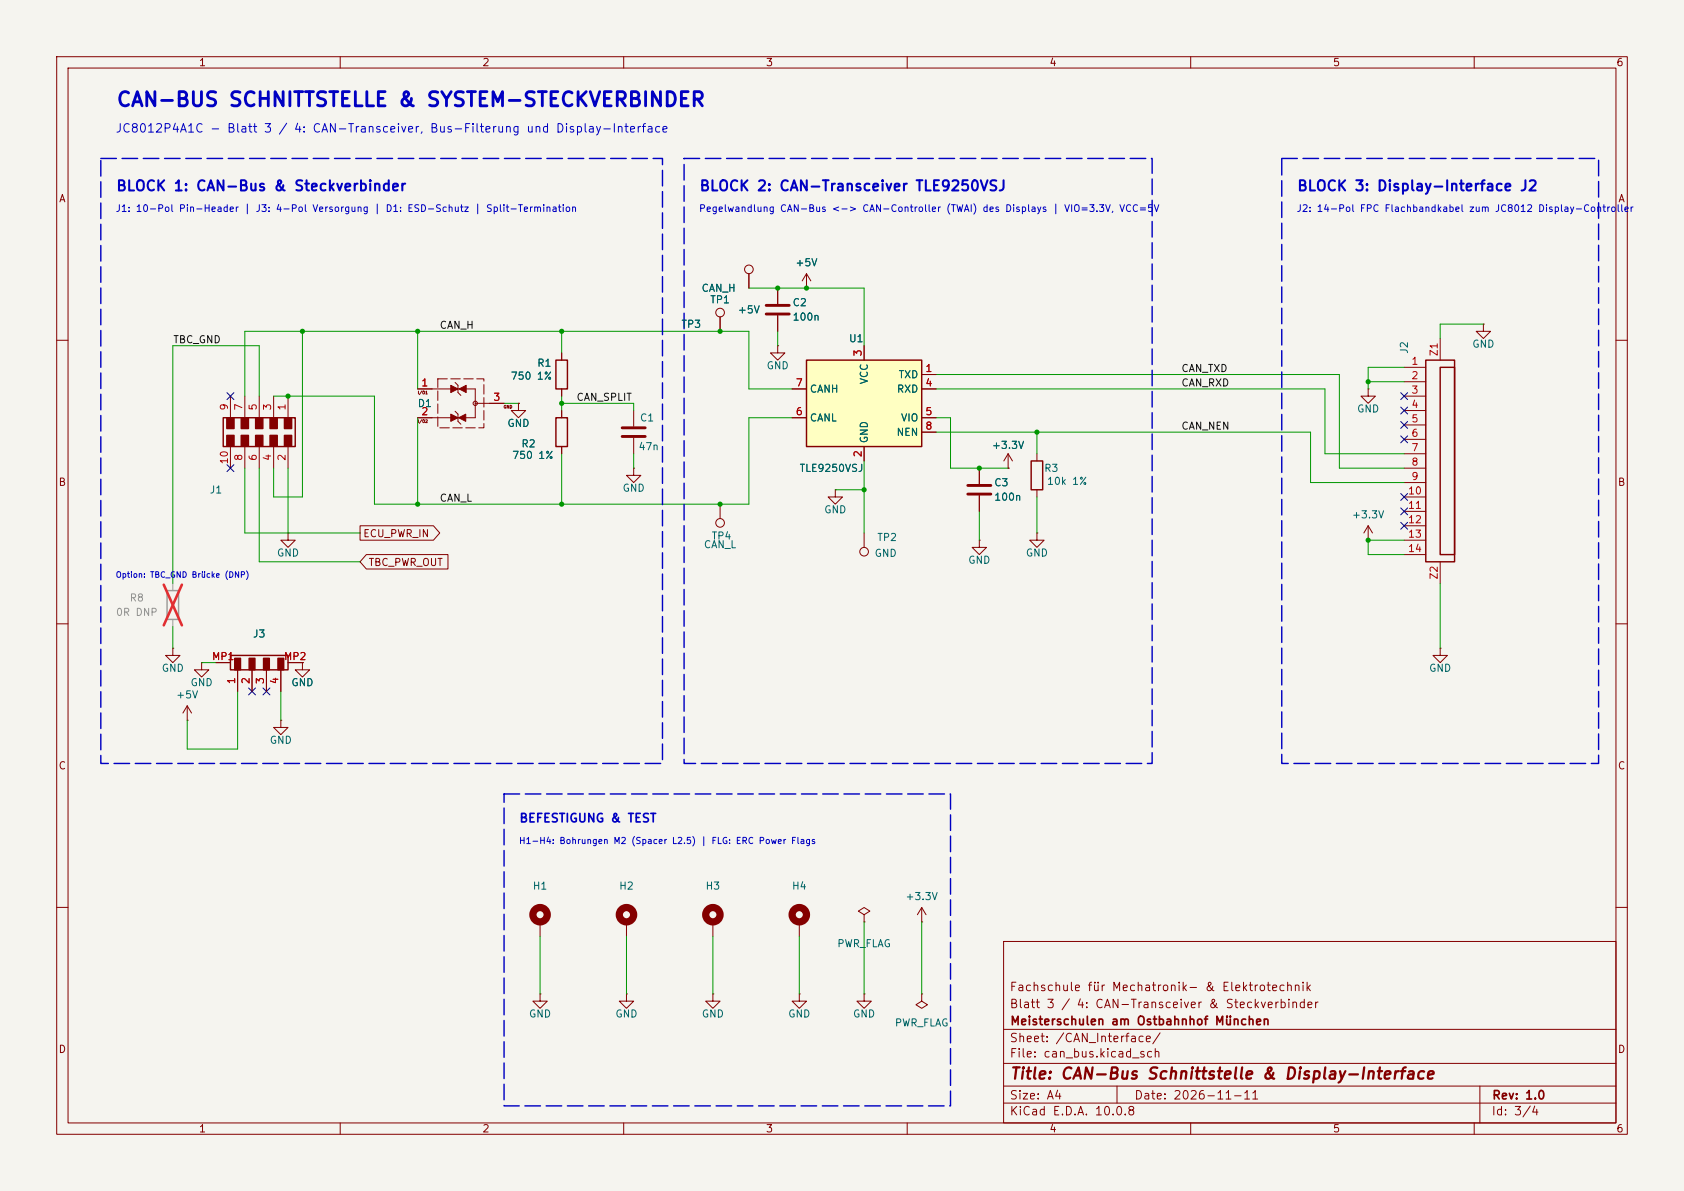
[picture p52: page 3]

CAN-BUS SCHNITTSTELLE & SYSTEM-STECKVERBINDER

Pegelwandlung CAN-Bus <-> CAN-Controller (TWAI) des Displays | VIO=3.3V, VCC=5V JC8012P4A1C - Blatt 3 / 4: CAN-Transceiver, Bus-Filterung und Display-Interface

BLOCK 1: CAN-Bus & Steckverbinder

J1: 10-Pol Pin-Header | J3: 4-Pol Versorgung | D1: ESD-Schutz | Split-Termination

J2: 14-Pol FPC Flachbandkabel zum JC8012 Display-Controller

BEFESTIGUNG & TEST H1-H4: Bohrungen M2 (Spacer L2.5) | FLG: ERC Power Flags

Blatt 3 / 4: CAN-Transceiver & Steckverbinder
Meisterschulen am Ostbahnhof München
Sheet: /CAN_Interface/
File: can_bus.kicad_sch
Title: CAN-Bus Schnittstelle & Display-Interface

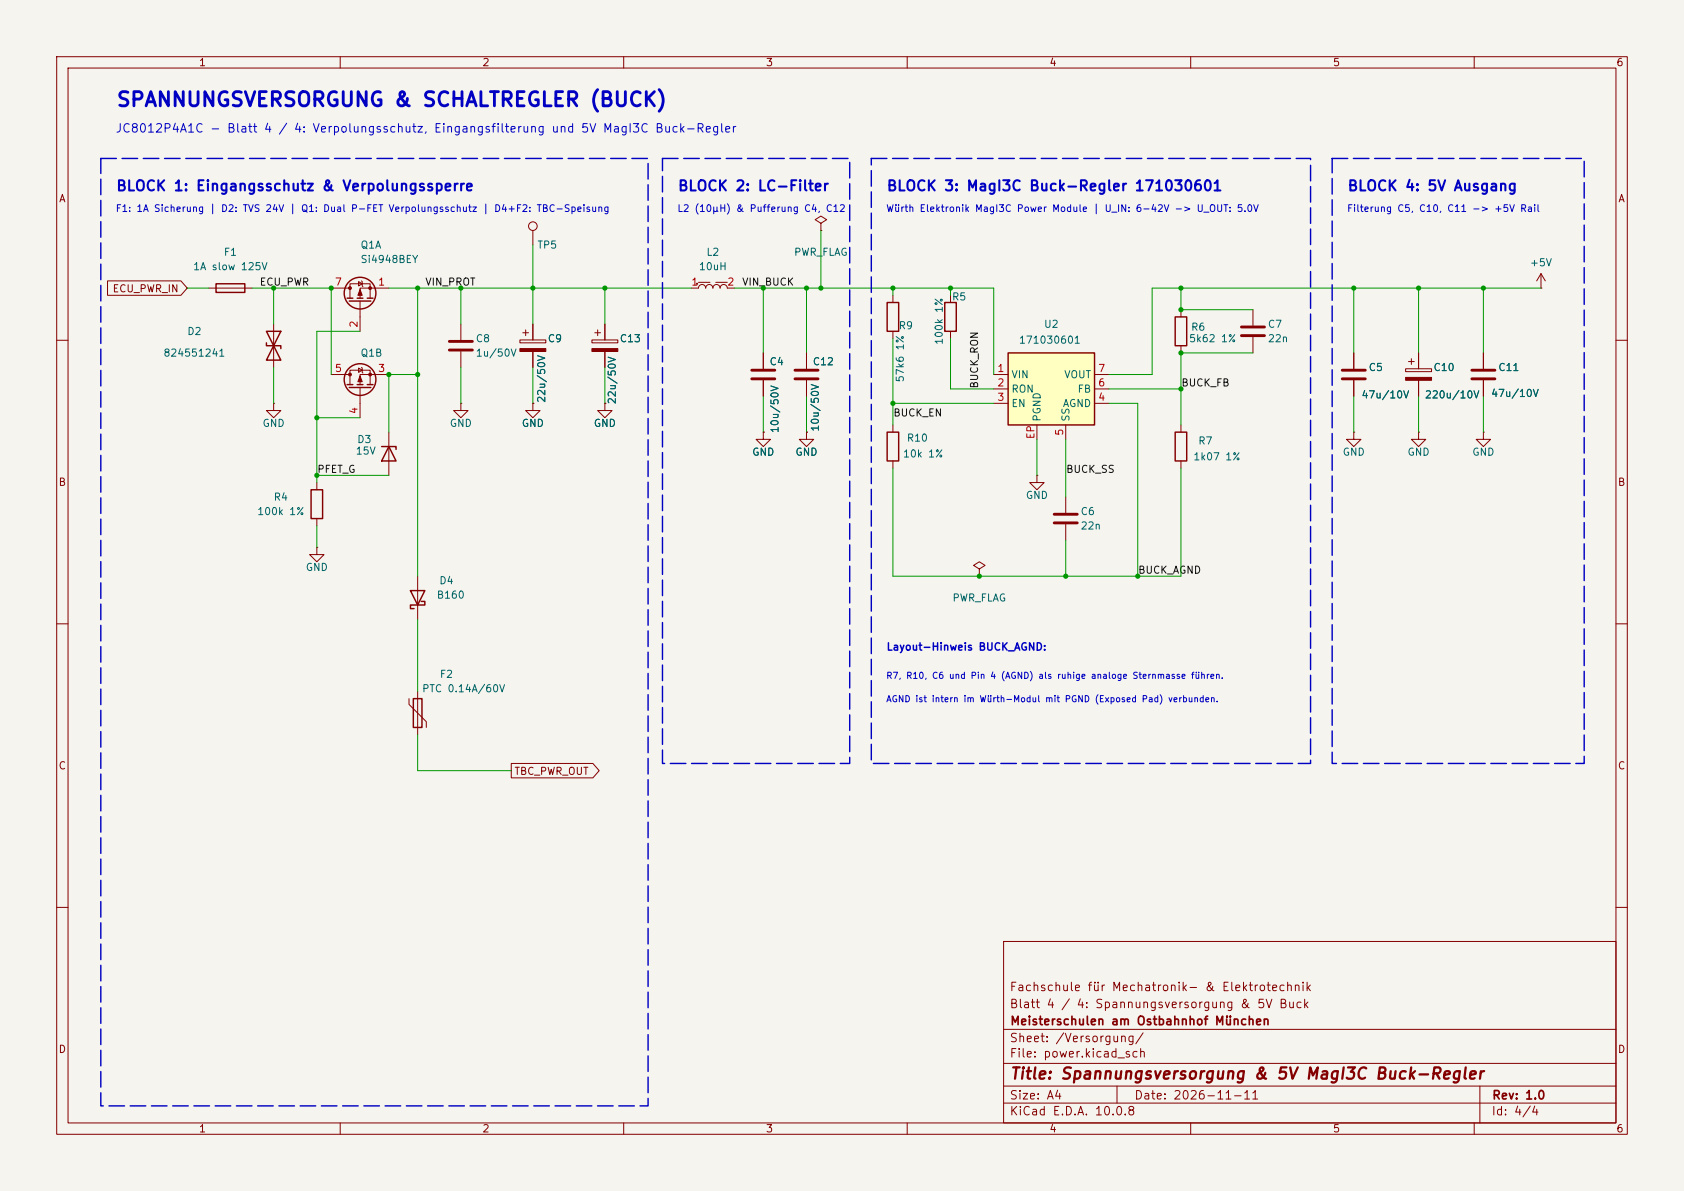
[picture p53: page 4]

JC8012P4A1C - Blatt 4 / 4: Verpolungsschutz, Eingangsfilterung und 5V MagI3C Buck-Regler F1: 1A Sicherung | D2: TVS 24V | Q1: Dual P-FET Verpolungsschutz | D4+F2: TBC-Speisung

R7, R10, C6 und Pin 4 (AGND) als ruhige analoge Sternmasse führen. AGND ist intern im Würth-Modul mit PGND (Exposed Pad) verbunden. BLOCK 1: Eingangsschutz & Verpolungssperre

Würth Elektronik MagI3C Power Module | U_IN: 6-42V -> U_OUT: 5.0V Layout-Hinweis BUCK_AGND:

Fachschule für Mechatronik- & Elektrotechnik R4

Blatt 4 / 4: Spannungsversorgung & 5V Buck
Meisterschulen am Ostbahnhof München
Sheet: /Versorgung/
File: power.kicad_sch
Title: Spannungsversorgung & 5V MagI3C Buck-Regler
