Meisterschulen-am-Ostbahnhof-Munchen/JC8012P4A1C_I_W_Y_CAN/pcbs/keypad/docs/JC8012P4A1C_keypad_schematic.pdf

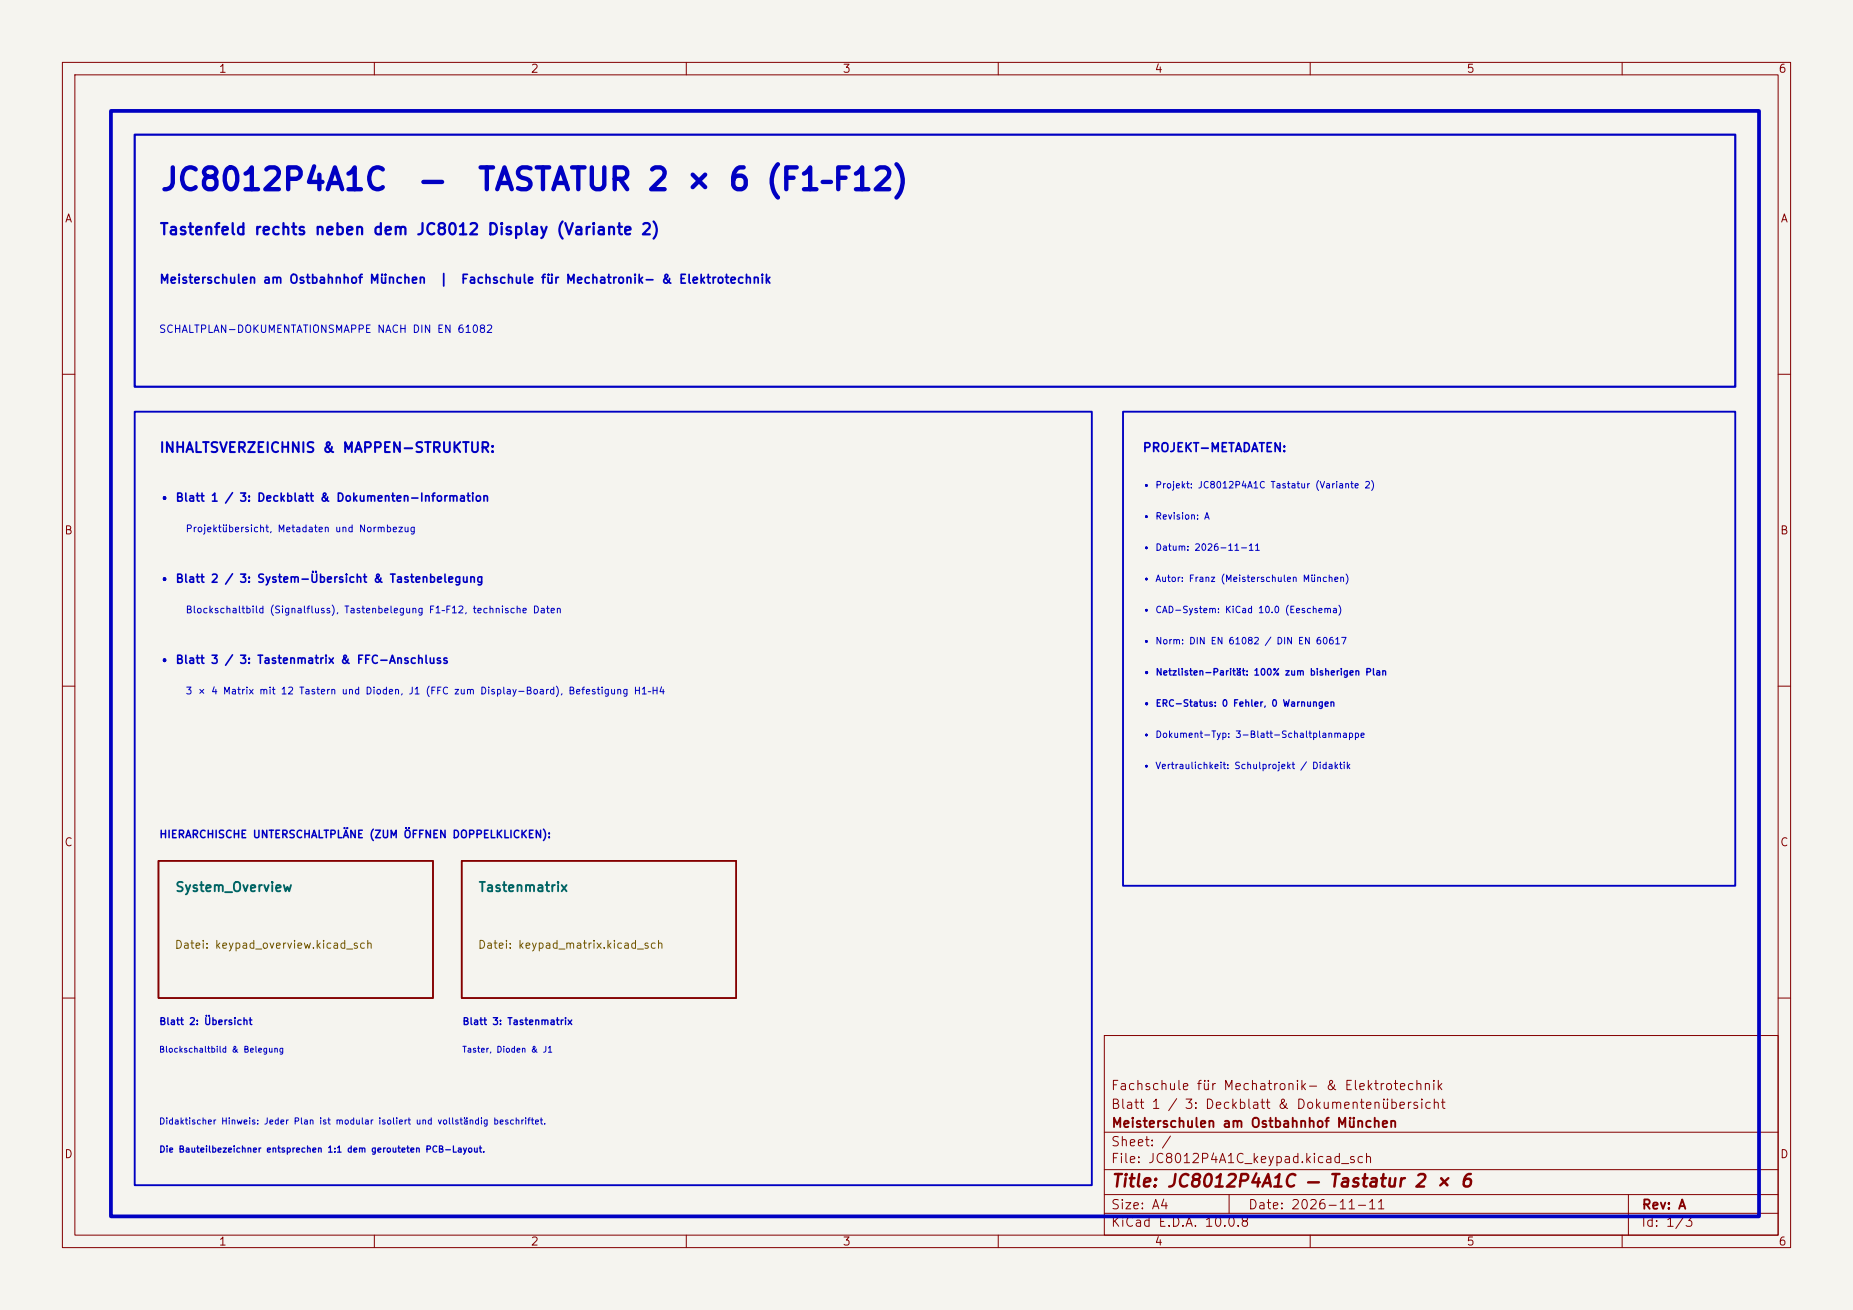
[picture p54: page 1]

• Revision: A Tastenfeld rechts neben dem JC8012 Display (Variante 2)

PROJEKT-METADATEN: • Projekt: JC8012P4A1C Tastatur (Variante 2) • Autor: Franz (Meisterschulen München) Didaktischer Hinweis: Jeder Plan ist modular isoliert und vollständig beschriftet. Blatt 2: Übersicht Blockschaltbild & Belegung Die Bauteilbezeichner entsprechen 1:1 dem gerouteten PCB-Layout. Blatt 3: Tastenmatrix
INHALTSVERZEICHNIS & MAPPEN-STRUKTUR:

Projektübersicht, Metadaten und Normbezug • Blatt 3 / 3: Tastenmatrix & FFC-Anschluss • Blatt 1 / 3: Deckblatt & Dokumenten-Information • Blatt 2 / 3: System-Übersicht & Tastenbelegung

Taster, Dioden & J1 Blockschaltbild (Signalfluss), Tastenbelegung F1–F12, technische Daten HIERARCHISCHE UNTERSCHALTPLÄNE (ZUM ÖFFNEN DOPPELKLICKEN):

Fachschule für Mechatronik- & Elektrotechnik Blatt 1 / 3: Deckblatt & Dokumentenübersicht Meisterschulen am Ostbahnhof München

Sheet: / File: JC8012P4A1C_keypad.kicad_sch | D Date: 2026-11-11
Title: JC8012P4A1C — Tastatur 2 × 6
Size: A4 | Rev: A

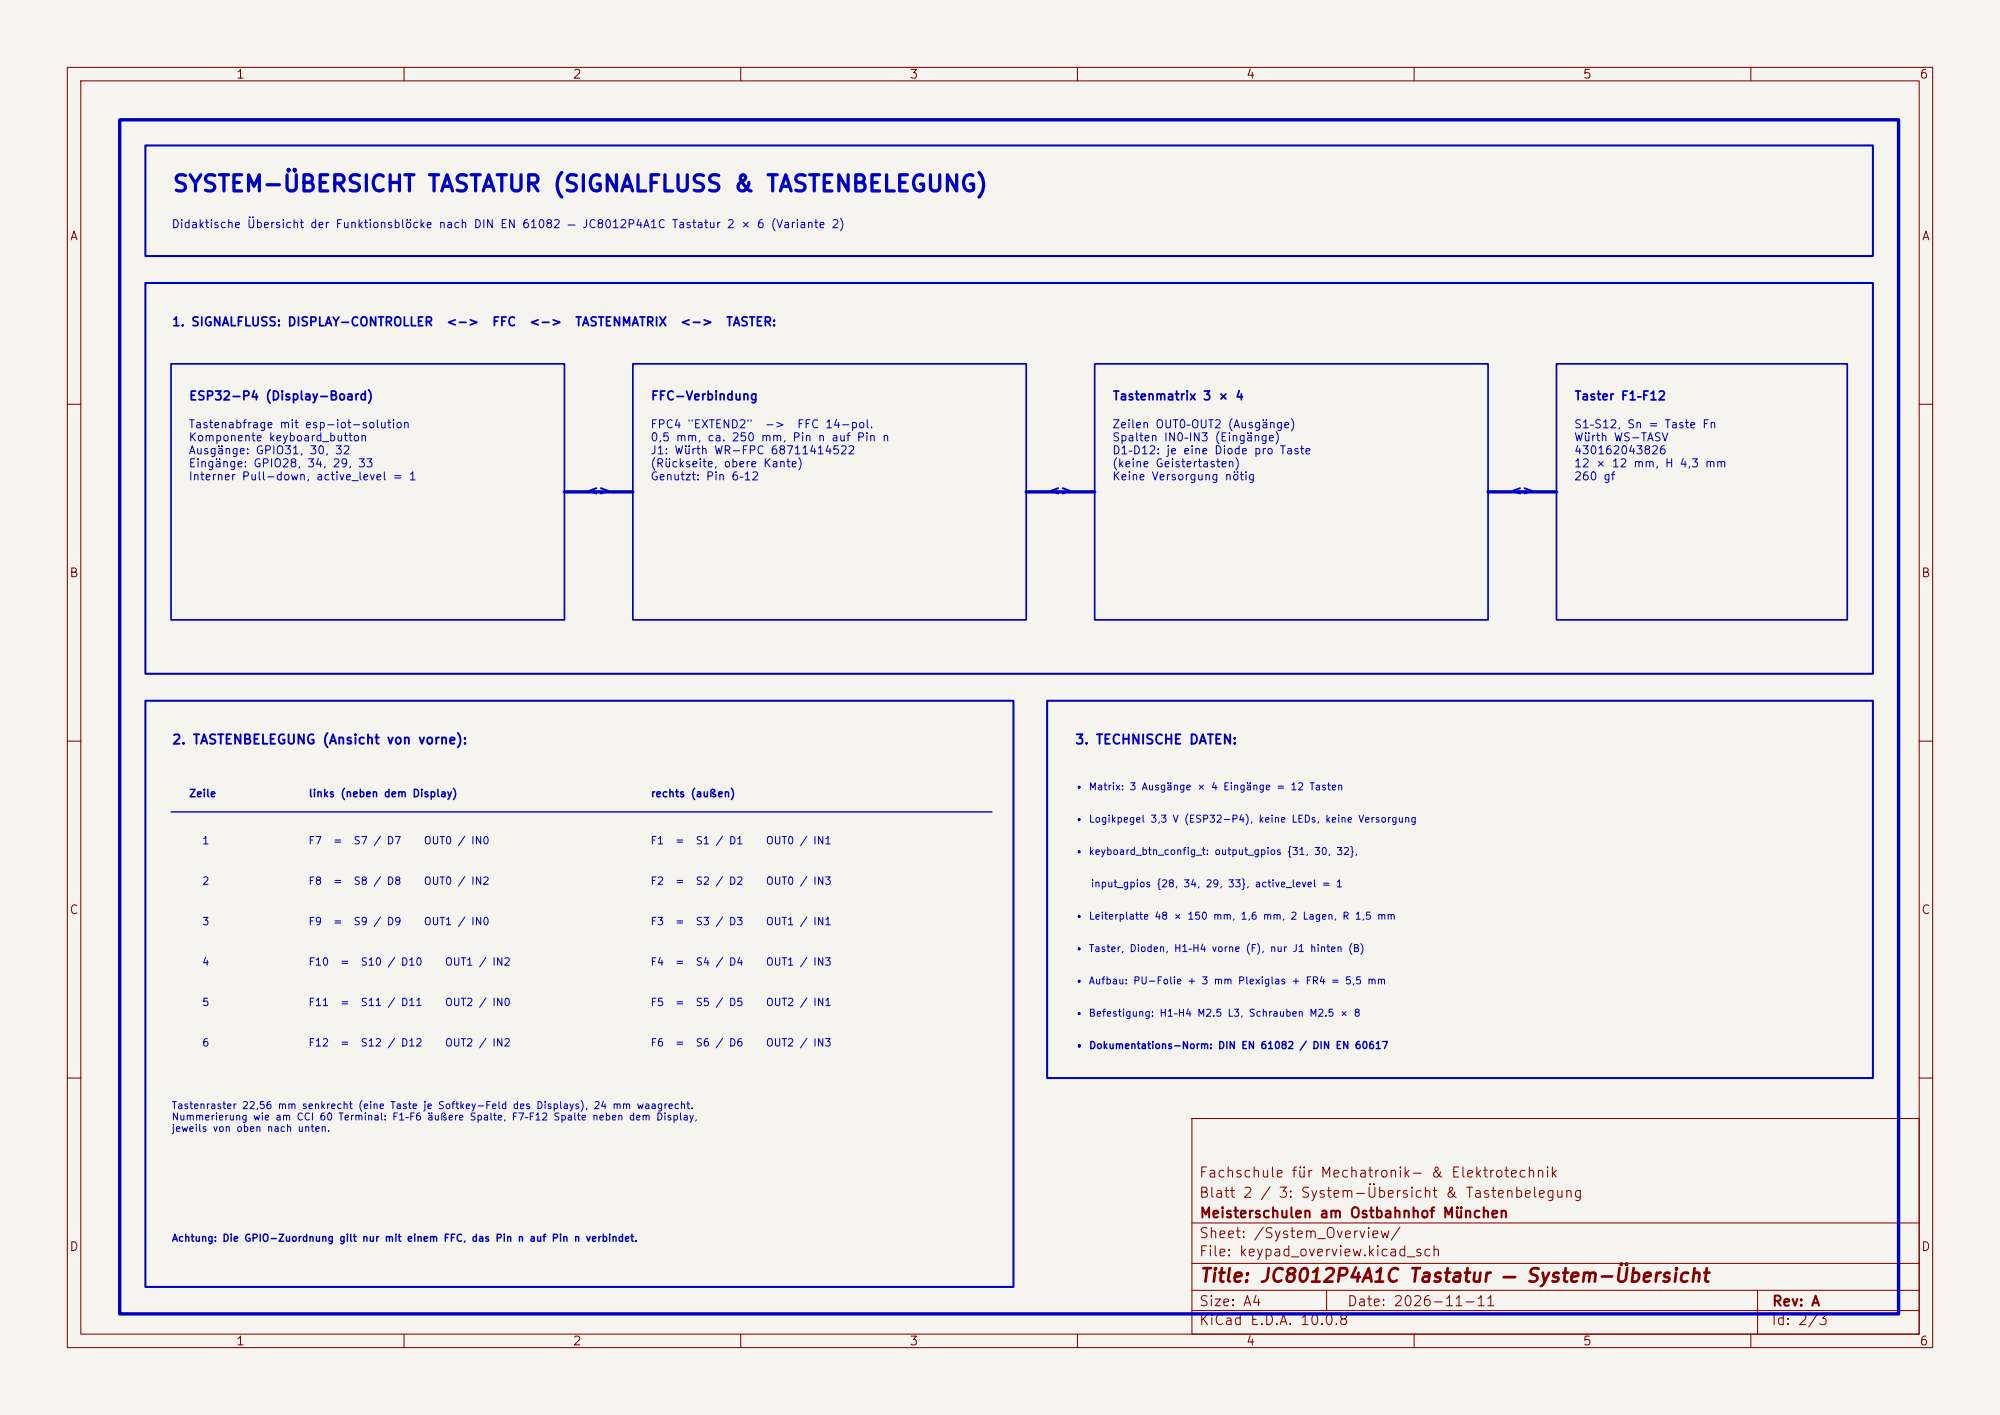
[picture p55: page 2]

Didaktische Übersicht der Funktionsblöcke nach DIN EN 61082 — JC8012P4A1C Tastatur 2 × 6 (Variante 2) 1
rechts (außen) <>

1. SIGNALFLUSS: DISPLAY-CONTROLLER <-> FFC <-> TASTENMATRIX <-> TASTER: Tastenabfrage mit esp-iot-solution

Interner Pull-down, active_level = 1 ESP32-P4 (Display-Board)

FPC4 "EXTEND2" -> FFC 14-pol. 0,5 mm, ca. 250 mm, Pin n auf Pin n
J1: Würth WR-FPC 68711414522
(Rückseite, obere Kante) Genutzt: Pin 6–12

Zeilen OUT0–OUT2 (Ausgänge)
Spalten IN0–IN3 (Eingänge) D1–D12: je eine Diode pro Taste

• Taster, Dioden, H1–H4 vorne (F), nur J1 hinten (B) • Dokumentations-Norm: DIN EN 61082 / DIN EN 60617 • Logikpegel 3,3 V (ESP32-P4), keine LEDs, keine Versorgung 3. TECHNISCHE DATEN: • Matrix: 3 Ausgänge × 4 Eingänge = 12 Tasten

• Aufbau: PU-Folie + 3 mm Plexiglas + FR4 = 5,5 mm
Fachschule für Mechatronik- & Elektrotechnik • Befestigung: H1–H4 M2.5 L3, Schrauben M2.5 × 8

Tastenraster 22,56 mm senkrecht (eine Taste je Softkey-Feld des Displays), 24 mm waagrecht. Nummerierung wie am CCI 60 Terminal: F1–F6 äußere Spalte, F7–F12 Spalte neben dem Display,

Blatt 2 / 3: System-Übersicht & Tastenbelegung Meisterschulen am Ostbahnhof München

Sheet: /System_Overview/ File: keypad_overview.kicad_sch | D Date: 2026-11-11
Title: JC8012P4A1C Tastatur — System-Übersicht

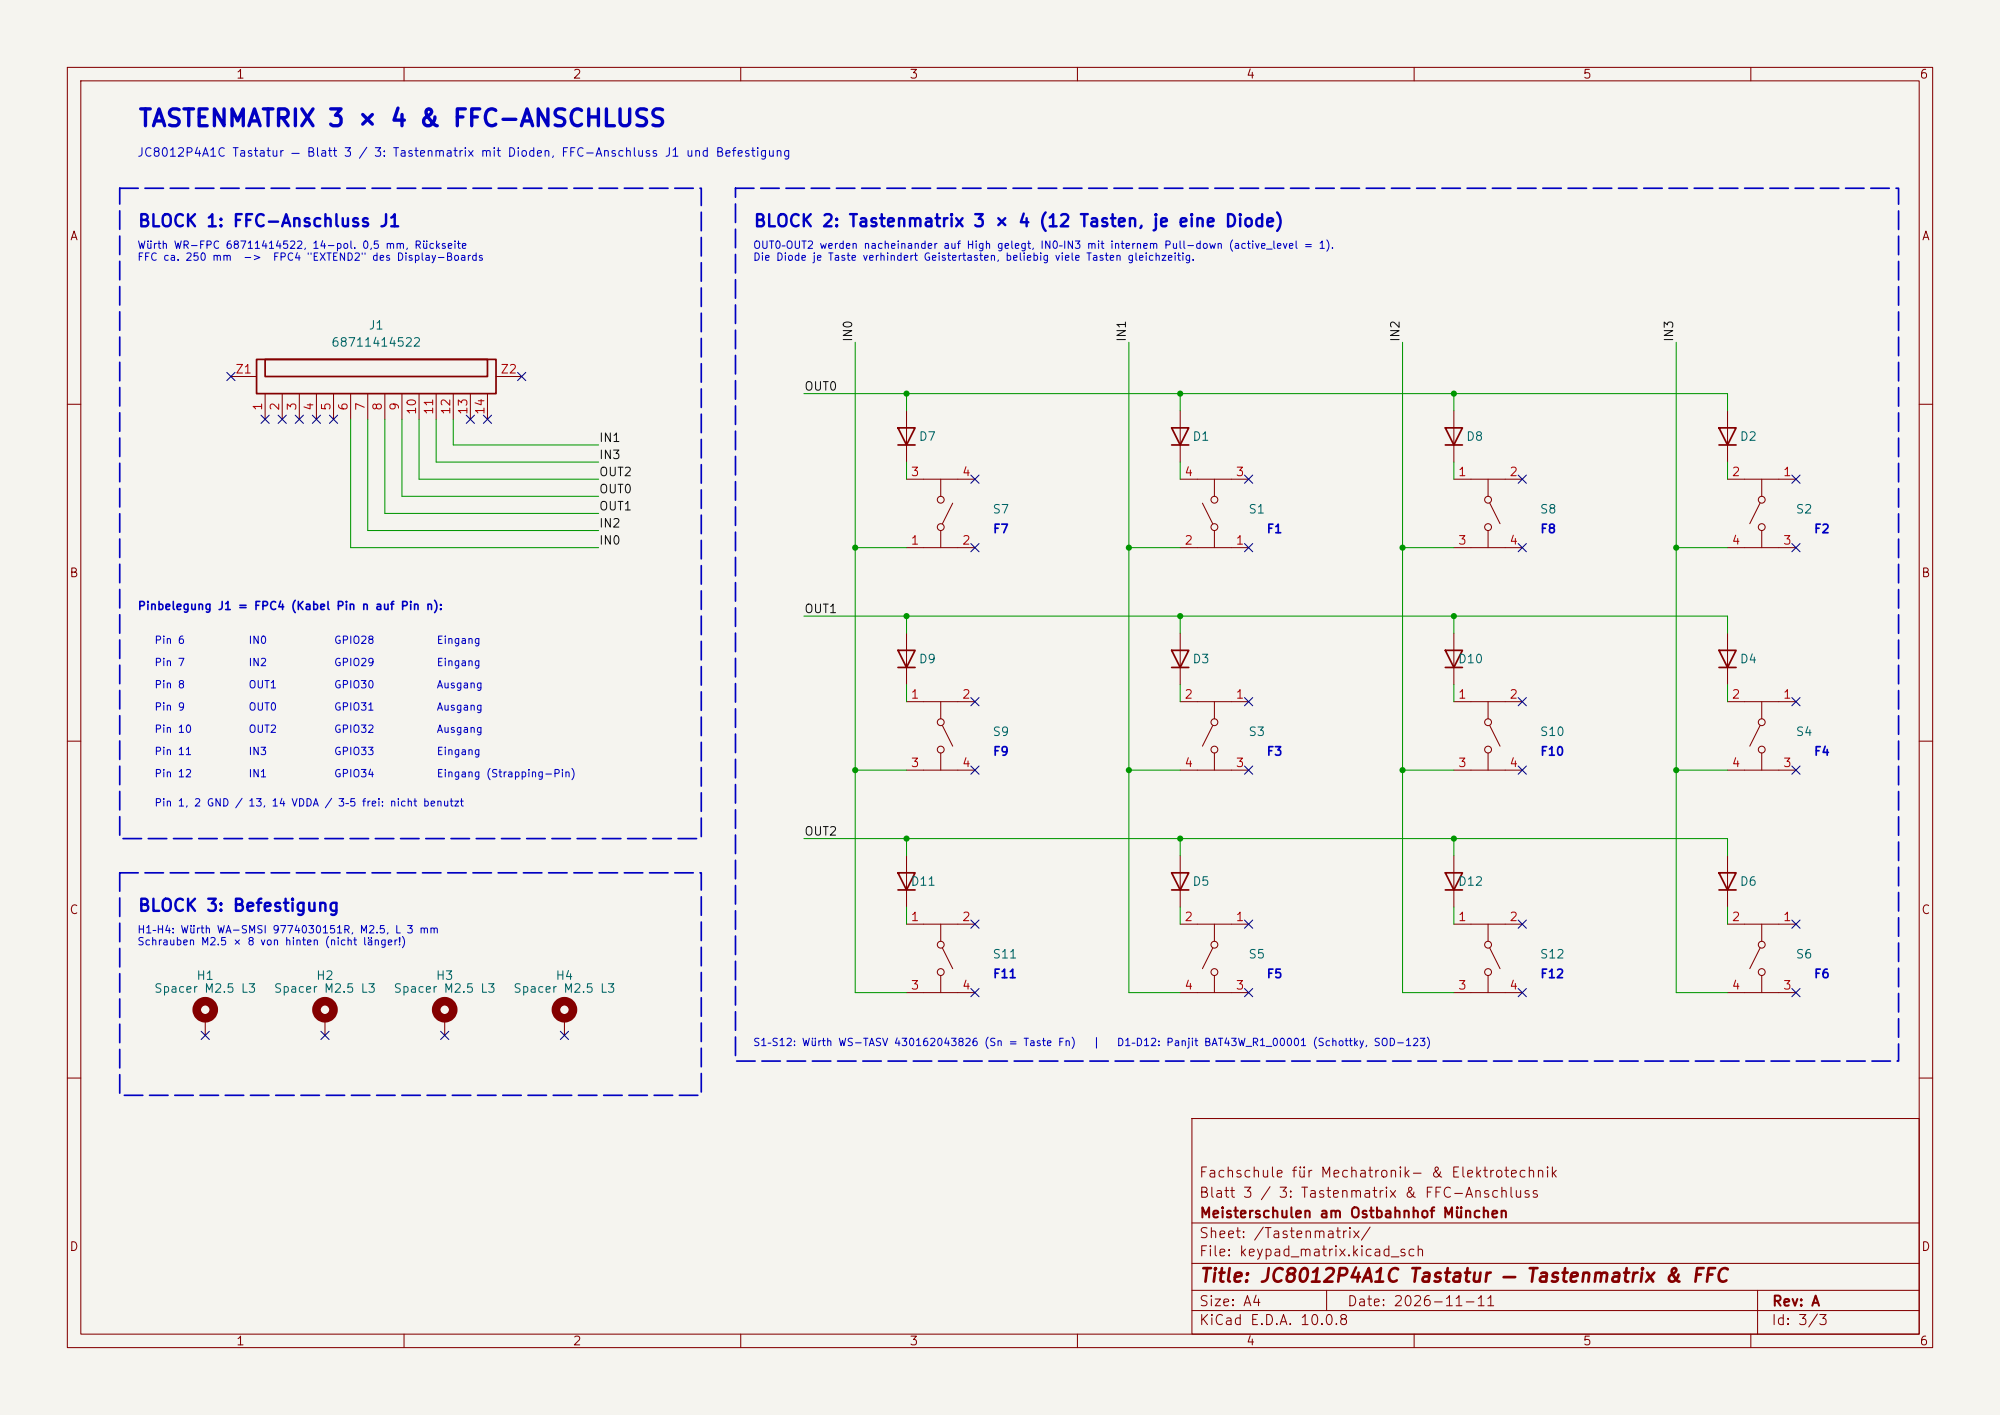
[picture p56: page 3]

IN0 Pin 9 Pin 8 Pin 6 Pin 7 TASTENMATRIX 3 × 4 & FFC-ANSCHLUSS

JC8012P4A1C Tastatur — Blatt 3 / 3: Tastenmatrix mit Dioden, FFC-Anschluss J1 und Befestigung

Eingang GPIO28 GPIO30 GPIO29 BLOCK 1: FFC-Anschluss J1

IN3 OUT2 Würth WR-FPC 68711414522, 14-pol. 0,5 mm, Rückseite
FFC ca. 250 mm -> FPC4 "EXTEND2" des Display-Boards

Eingang (Strapping-Pin) H1–H4: Würth WA-SMSI 9774030151R, M2.5, L 3 mm

Fachschule für Mechatronik- & Elektrotechnik
Blatt 3 / 3: Tastenmatrix & FFC-Anschluss
Meisterschulen am Ostbahnhof München
Sheet: /Tastenmatrix/
File: keypad_matrix.kicad_sch
Title: JC8012P4A1C Tastatur — Tastenmatrix & FFC
