Meisterschulen-am-Ostbahnhof-Munchen/JC8012P4A1C_I_W_Y_CAN/pcbs/can_power/JC8012P4A1C_I_W_Y_CAN.kicad_pcb

## KiCad design pcbs/can_power/JC8012P4A1C_I_W_Y_CAN.kicad_pcb (2026-11-13)

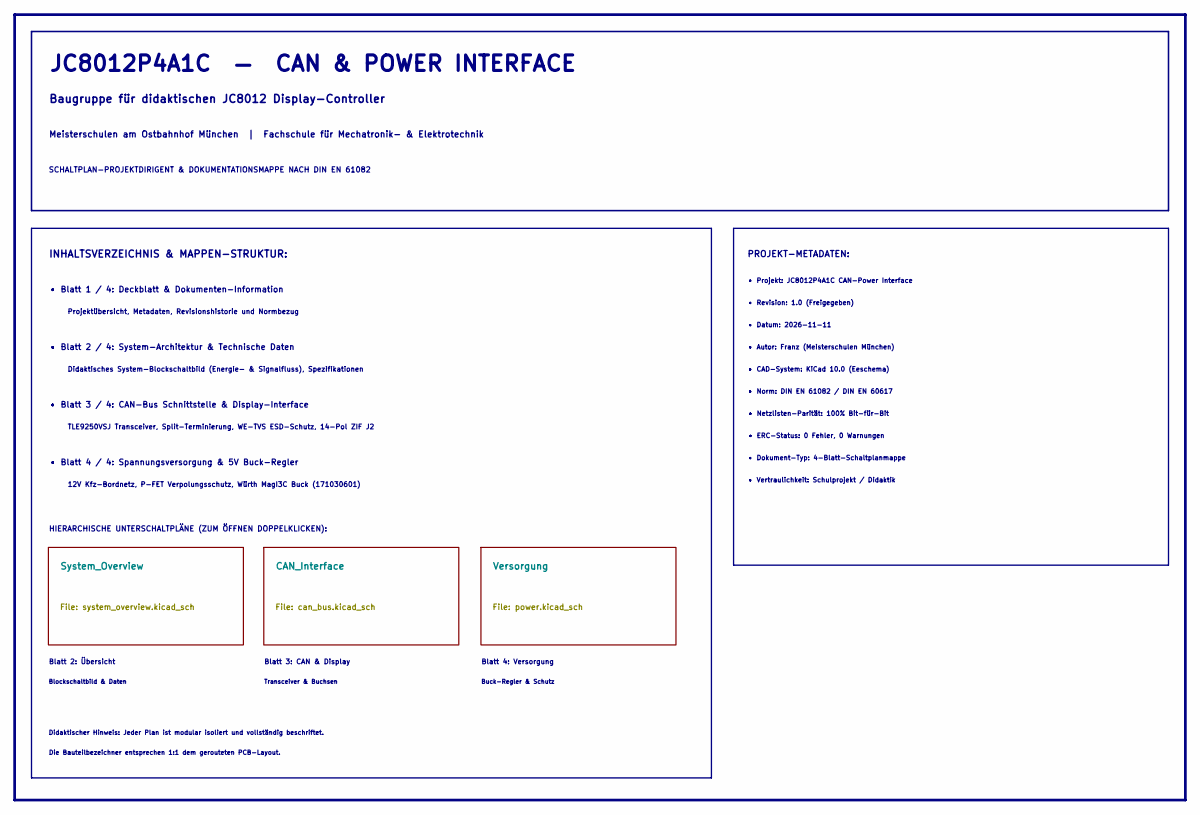
[picture p57: schematic JC8012P4A1C_I_W_Y_CAN.kicad_sch, JC8012P4A1C — CAN & Power Interface]

Notes on the sheet:
Projektübersicht, Metadaten, Revisionshistorie und Normbezug
12V Kfz-Bordnetz, P-FET Verpolungsschutz, Würth MagI3C Buck (171030601)
Blatt 2: Übersicht
• CAD-System: KiCad 10.0 (Eeschema)
• Revision: 1.0 (Freigegeben)
HIERARCHISCHE UNTERSCHALTPLÄNE (ZUM ÖFFNEN DOPPELKLICKEN):
Didaktisches System-Blockschaltbild (Energie- & Signalfluss), Spezifikationen
• Netzlisten-Parität: 100% Bit-für-Bit
PROJEKT-METADATEN:
Meisterschulen am Ostbahnhof München | Fachschule für Mechatronik- & Elektrotechnik
• Norm: DIN EN 61082 / DIN EN 60617
• Blatt 3 / 4: CAN-Bus Schnittstelle & Display-Interface
Baugruppe für didaktischen JC8012 Display-Controller
• Dokument-Typ: 4-Blatt-Schaltplanmappe
• ERC-Status: 0 Fehler, 0 Warnungen
Blatt 4: Versorgung
INHALTSVERZEICHNIS & MAPPEN-STRUKTUR:
• Blatt 4 / 4: Spannungsversorgung & 5V Buck-Regler
Buck-Regler & Schutz
• Blatt 2 / 4: System-Architektur & Technische Daten
Blatt 3: CAN & Display
Blockschaltbild & Daten
SCHALTPLAN-PROJEKTDIRIGENT & DOKUMENTATIONSMAPPE NACH DIN EN 61082
• Datum: 2026-11-11
• Vertraulichkeit: Schulprojekt / Didaktik
JC8012P4A1C — CAN & POWER INTERFACE
• Blatt 1 / 4: Deckblatt & Dokumenten-Information
Die Bauteilbezeichner entsprechen 1:1 dem gerouteten PCB-Layout.
Transceiver & Buchsen
TLE9250VSJ Transceiver, Split-Terminierung, WE-TVS ESD-Schutz, 14-Pol ZIF J2
Didaktischer Hinweis: Jeder Plan ist modular isoliert und vollständig beschriftet.
• Autor: Franz (Meisterschulen München)
• Projekt: JC8012P4A1C CAN-Power Interface

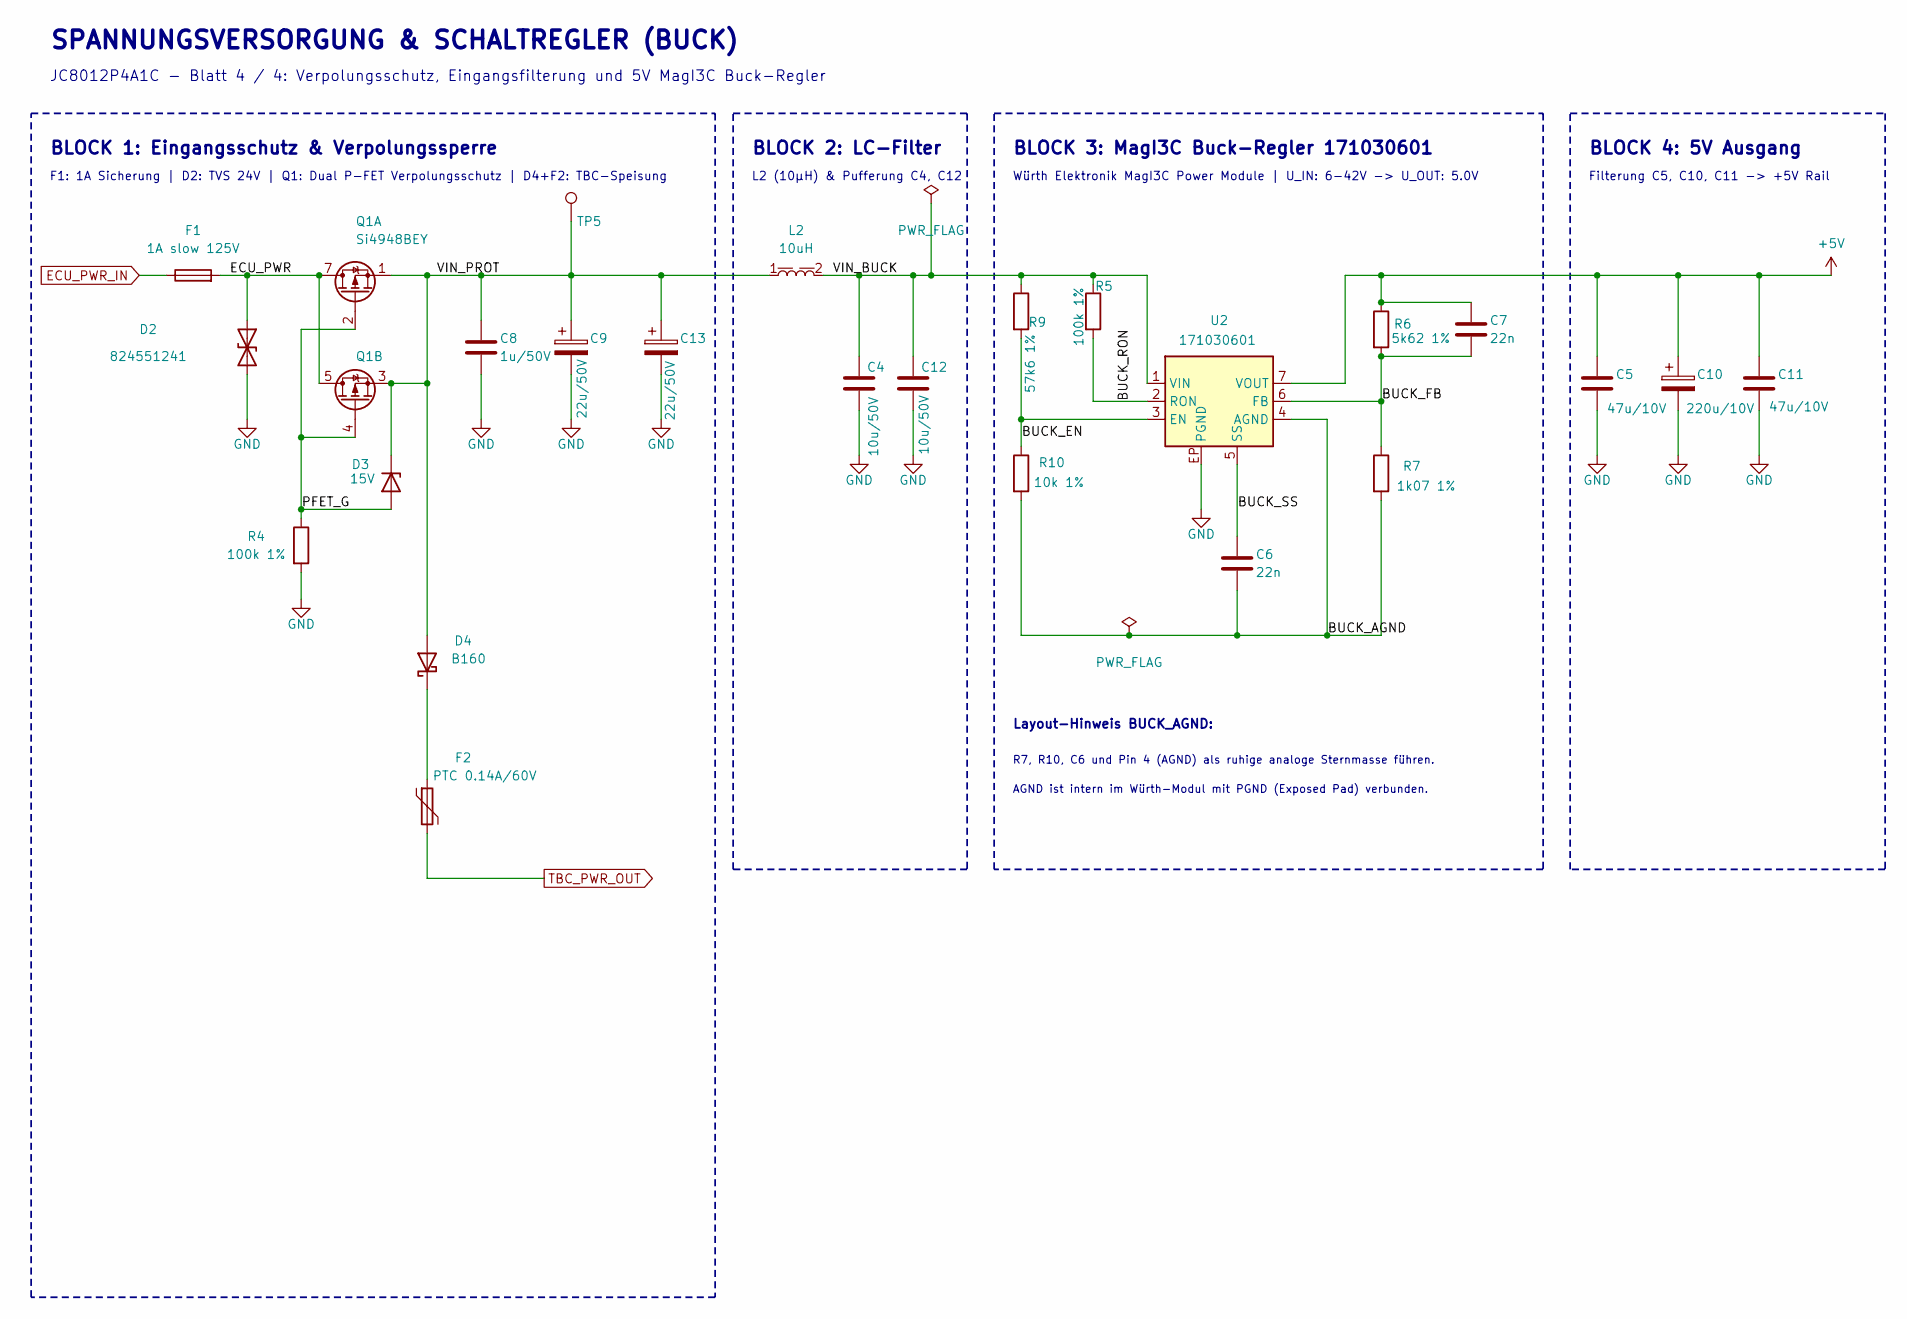
[picture p58: schematic power.kicad_sch, Spannungsversorgung & 5V MagI3C Buck-Regler]

Parts:
C4, C12: 10u/50V; C_1210_3225Metric; MPN 885012209073
C5, C11: 47u/10V; C_1210_3225Metric; MPN 885012109007
C6, C7: 22n; C_0603_1608Metric; MPN 885012206091
C8: 1u/50V; C_1210_3225Metric; MPN 885012209047
C9, C13: 22u/50V; CP_Wurth_WCAP-ASLI-D6.3L5.5; MPN 865080643008
C10: 220u/10V; CP_Wurth_WCAP-PSLP-D6.3L5.8; MPN 875105244013
D2: 824551241; D_Wurth_WE-TVSP-DO214-AB-3000W_BI; MPN 824551241
D3: 15V; D_SOD-123; MPN MMSZ5245B_R1_00001
D4: B160; D_SMA; MPN B160-13-F
F1: 1A slow 125V; Fuse_Littelfuse-NANO2-451_453; MPN 0452001.MRL
F2: PTC 0.14A/60V; Fuse_1812_4532Metric; MPN MF-MSMF014-2
L2: 10uH; L_Wurth_WE-PD2-5848; MPN 74477410
Q1: Si4948BEY; SOIC-8_3.9x4.9mm_P1.27mm; MPN SI4948BEY-T1-E3
R4, R5: 100k 1%; R_0603_1608Metric; MPN RC0603FR-07100KL
R6: 5k62 1%; R_0603_1608Metric; MPN RC0603FR-075K62L
R7: 1k07 1%; R_0603_1608Metric; MPN RC0603FR-071K07L
R9: 57k6 1%; R_0603_1608Metric; MPN RC0603FR-0757K6L
R10: 10k 1%; R_0603_1608Metric; MPN RC0603FR-0710KL
TP5: VIN_PROT; TestPoint_Pad_D1.5mm
U2: 171030601; U_Wurth_WPME-VDRM-TO263-7EP; MPN 171030601

Connections:
+5V: C5.1, C7.1, C10.1, C11.1, R6.1, U2.7 (VOUT); also elsewhere on the board
/Versorgung/BUCK_AGND: C6.2, R7.2, R10.2, U2.4 (AGND)
/Versorgung/BUCK_EN: R9.2, R10.1, U2.3 (EN)
/Versorgung/BUCK_FB: C7.2, R6.2, R7.1, U2.6 (FB)
/Versorgung/BUCK_RON: R5.2, U2.2 (RON)
/Versorgung/BUCK_SS: C6.1, U2.5 (SS)
/Versorgung/ECU_PWR: D2.1 (A1), F1.2, Q1.5 (D2), Q1.6 (D2), Q1.7 (D1), Q1.8 (D1)
/Versorgung/PFET_G: D3.2 (A), Q1.2 (G1), Q1.4 (G2), R4.1
/Versorgung/VIN_BUCK: C4.1, C12.1, L2.2, R5.1, R9.1, U2.1 (VIN)
/Versorgung/VIN_PROT: C8.1, C9.1, C13.1, D3.1 (K), D4.2 (A), L2.1, Q1.1 (S1), Q1.3 (S2), TP5.1 (1_1)
unnamed: D4.1 (K), F2.1
TBC_PWR_OUT: F2.2; also elsewhere on the board

Notes on the sheet:
Würth Elektronik MagI3C Power Module | U_IN: 6-42V -> U_OUT: 5.0V
JC8012P4A1C - Blatt 4 / 4: Verpolungsschutz, Eingangsfilterung und 5V MagI3C Buck-Regler
R7, R10, C6 und Pin 4 (AGND) als ruhige analoge Sternmasse führen.
BLOCK 3: MagI3C Buck-Regler 171030601
BLOCK 4: 5V Ausgang
Layout-Hinweis BUCK_AGND:
AGND ist intern im Würth-Modul mit PGND (Exposed Pad) verbunden.
F1: 1A Sicherung | D2: TVS 24V | Q1: Dual P-FET Verpolungsschutz | D4+F2: TBC-Speisung
BLOCK 1: Eingangsschutz & Verpolungssperre
L2 (10µH) & Pufferung C4, C12
Filterung C5, C10, C11 -> +5V Rail
SPANNUNGSVERSORGUNG & SCHALTREGLER (BUCK)
BLOCK 2: LC-Filter

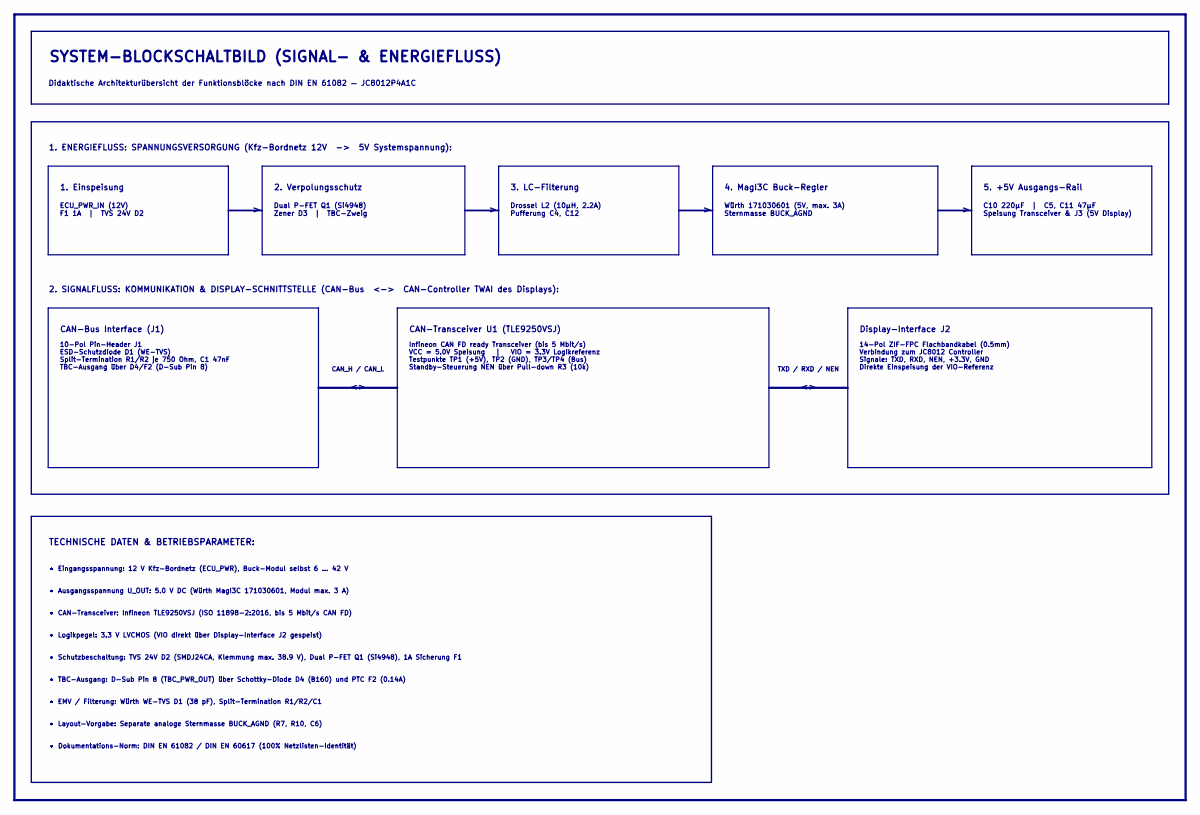
[picture p59: schematic system_overview.kicad_sch, JC8012P4A1C — System-Architektur]

Notes on the sheet:
1. Einspeisung
5. +5V Ausgangs-Rail
• Schutzbeschaltung: TVS 24V D2 (SMDJ24CA, Klemmung max. 38.9 V), Dual P-FET Q1 (Si4948), 1A Sicherung F1
TECHNISCHE DATEN & BETRIEBSPARAMETER:
CAN_H / CAN_L
Würth 171030601 (5V, max. 3A) Sternmasse BUCK_AGND
• EMV / Filterung: Würth WE-TVS D1 (38 pF), Split-Termination R1/R2/C1
• Layout-Vorgabe: Separate analoge Sternmasse BUCK_AGND (R7, R10, C6)
• CAN-Transceiver: Infineon TLE9250VSJ (ISO 11898-2:2016, bis 5 Mbit/s CAN FD)
Drossel L2 (10µH, 2.2A) Pufferung C4, C12
Infineon CAN FD ready Transceiver (bis 5 Mbit/s) VCC = 5.0V Speisung | VIO = 3.3V Logikreferenz Testpunkte TP1 (+5V), TP2 (GND), TP3/TP4 (Bus) Standby-Steuerung NEN über Pull-down R3 (10k)
CAN-Transceiver U1 (TLE9250VSJ)
Dual P-FET Q1 (Si4948) Zener D3 | TBC-Zweig
Didaktische Architekturübersicht der Funktionsblöcke nach DIN EN 61082 — JC8012P4A1C
1. ENERGIEFLUSS: SPANNUNGSVERSORGUNG (Kfz-Bordnetz 12V -> 5V Systemspannung):
4. MagI3C Buck-Regler
14-Pol ZIF-FPC Flachbandkabel (0.5mm) Verbindung zum JC8012 Controller Signale: TXD, RXD, NEN, +3.3V, GND Direkte Einspeisung der VIO-Referenz
TXD / RXD / NEN
2. SIGNALFLUSS: KOMMUNIKATION & DISPLAY-SCHNITTSTELLE (CAN-Bus <-> CAN-Controller TWAI des Displays):
3. LC-Filterung
C10 220µF | C5, C11 47µF Speisung Transceiver & J3 (5V Display)
• TBC-Ausgang: D-Sub Pin 8 (TBC_PWR_OUT) über Schottky-Diode D4 (B160) und PTC F2 (0.14A)
• Dokumentations-Norm: DIN EN 61082 / DIN EN 60617 (100% Netzlisten-Identität)
• Logikpegel: 3.3 V LVCMOS (VIO direkt über Display-Interface J2 gespeist)
Display-Interface J2
2. Verpolungsschutz
CAN-Bus Interface (J1)
• Ausgangsspannung U_OUT: 5.0 V DC (Würth MagI3C 171030601, Modul max. 3 A)
ECU_PWR_IN (12V) F1 1A | TVS 24V D2
10-Pol Pin-Header J1 ESD-Schutzdiode D1 (WE-TVS) Split-Termination R1/R2 je 750 Ohm, C1 47nF TBC-Ausgang über D4/F2 (D-Sub Pin 8)
• Eingangsspannung: 12 V Kfz-Bordnetz (ECU_PWR), Buck-Modul selbst 6 ... 42 V
SYSTEM-BLOCKSCHALTBILD (SIGNAL- & ENERGIEFLUSS)

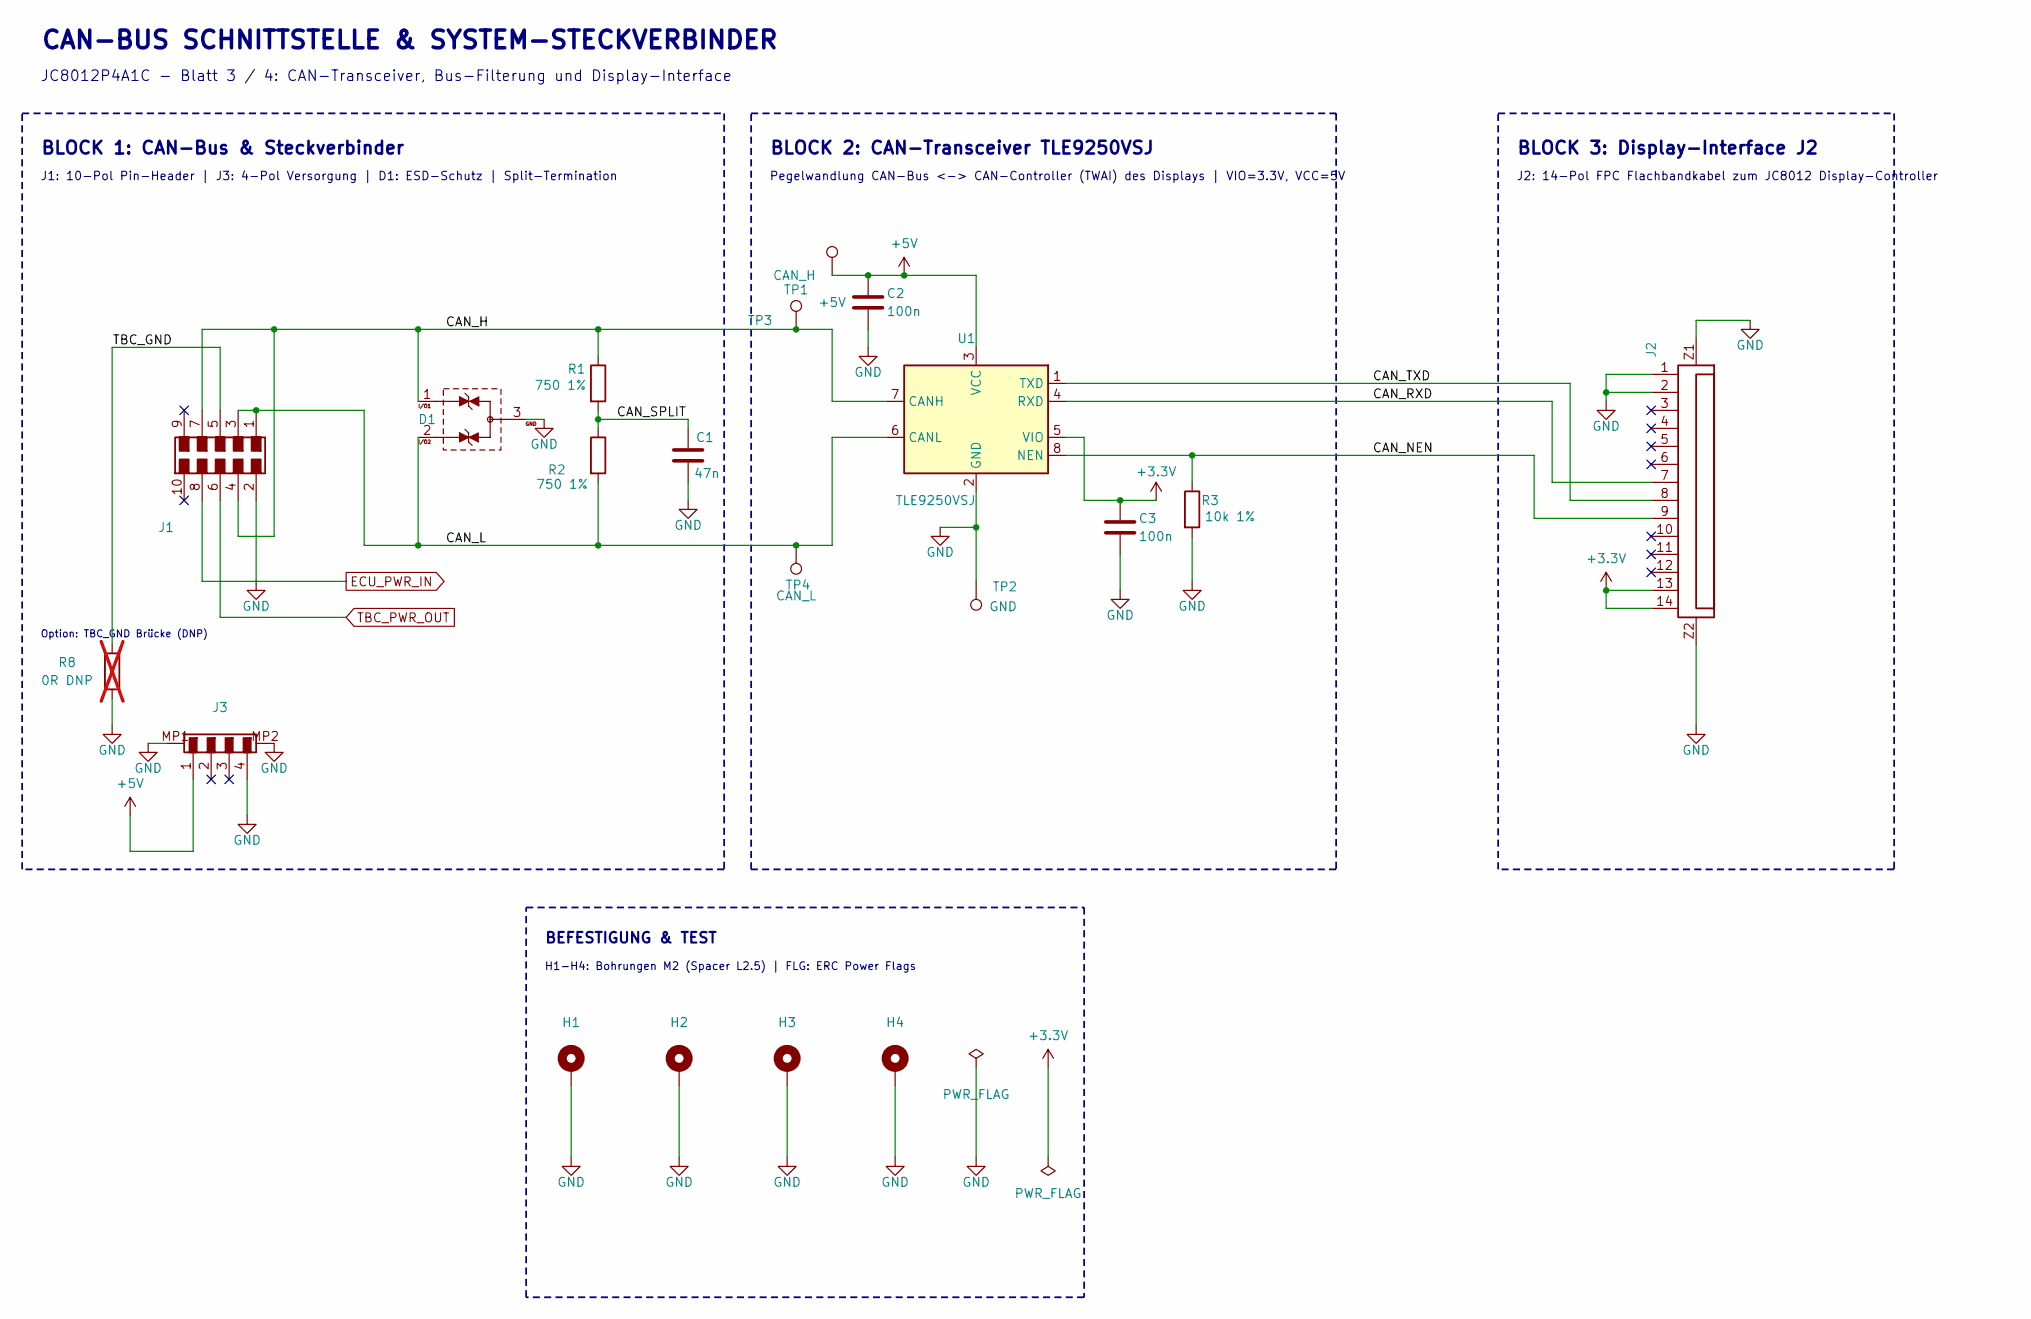
[picture p60: schematic can_bus.kicad_sch, CAN-Bus Schnittstelle & Display-Interface]

Parts:
C1: 47n; C_0603_1608Metric; MPN 885012206093
C2, C3: 100n; C_0603_1608Metric; MPN 885012206095
D1: 824094024; D_Wurth_WE-TVS-SOT23-3L; MPN 824094024
H1, H2, H3, H4: Spacer M2 L2.5; A_Wurth_WA-SMST_9774025943R; MPN 9774025943R
J1: 610110249121; J_Wurth_WR-PHD_610110249121; MPN 610110249121
J2: 68711414522; J_Wurth_WR-FPC_68711414522; MPN 68711414522
J3: 653104131822; J_Wurth_WR-WTB_653104131822; MPN 653104131822
R1, R2: 750 1%; R_1206_3216Metric; MPN RC1206FR-07750RL
R3: 10k 1%; R_0603_1608Metric; MPN RC0603FR-0710KL
R8: 0R DNP; R_0603_1608Metric; MPN RC0603JR-070RL; not fitted
TP1: +5V; TestPoint_Pad_D1.5mm
TP2: GND; TestPoint_Pad_D1.5mm
TP3: CAN_H; TestPoint_Pad_D1.5mm
TP4: CAN_L; TestPoint_Pad_D1.5mm
U1: TLE9250VSJ; SOIC-8_3.9x4.9mm_P1.27mm; MPN TLE9250VSJXUMA1

Connections:
+3.3V: C3.1, J2.13, J2.14, U1.5 (VIO)
+5V: C2.1, J3.1, TP1.1 (1_1), U1.3 (VCC); also elsewhere on the board
/CAN_Interface/CAN_H: D1.1 (I/O1), J1.4, J1.7, R1.1, TP3.1 (1_1), U1.7 (CANH)
/CAN_Interface/CAN_L: D1.2 (I/O2), J1.1, J1.3, R2.2, TP4.1 (1_1), U1.6 (CANL)
/CAN_Interface/CAN_NEN: J2.9, R3.1, U1.8 (NEN)
/CAN_Interface/CAN_RXD: J2.7, U1.4 (RXD)
/CAN_Interface/CAN_SPLIT: C1.1, R1.2, R2.1
/CAN_Interface/CAN_TXD: J2.8, U1.1 (TXD)
/CAN_Interface/TBC_GND: J1.5, R8.1
TBC_PWR_OUT: J1.6; also elsewhere on the board

Notes on the sheet:
Pegelwandlung CAN-Bus <-> CAN-Controller (TWAI) des Displays | VIO=3.3V, VCC=5V
JC8012P4A1C - Blatt 3 / 4: CAN-Transceiver, Bus-Filterung und Display-Interface
H1-H4: Bohrungen M2 (Spacer L2.5) | FLG: ERC Power Flags
BEFESTIGUNG & TEST
BLOCK 1: CAN-Bus & Steckverbinder
BLOCK 2: CAN-Transceiver TLE9250VSJ
J2: 14-Pol FPC Flachbandkabel zum JC8012 Display-Controller
BLOCK 3: Display-Interface J2
Option: TBC_GND Brücke (DNP)
CAN-BUS SCHNITTSTELLE & SYSTEM-STECKVERBINDER
J1: 10-Pol Pin-Header | J3: 4-Pol Versorgung | D1: ESD-Schutz | Split-Termination

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
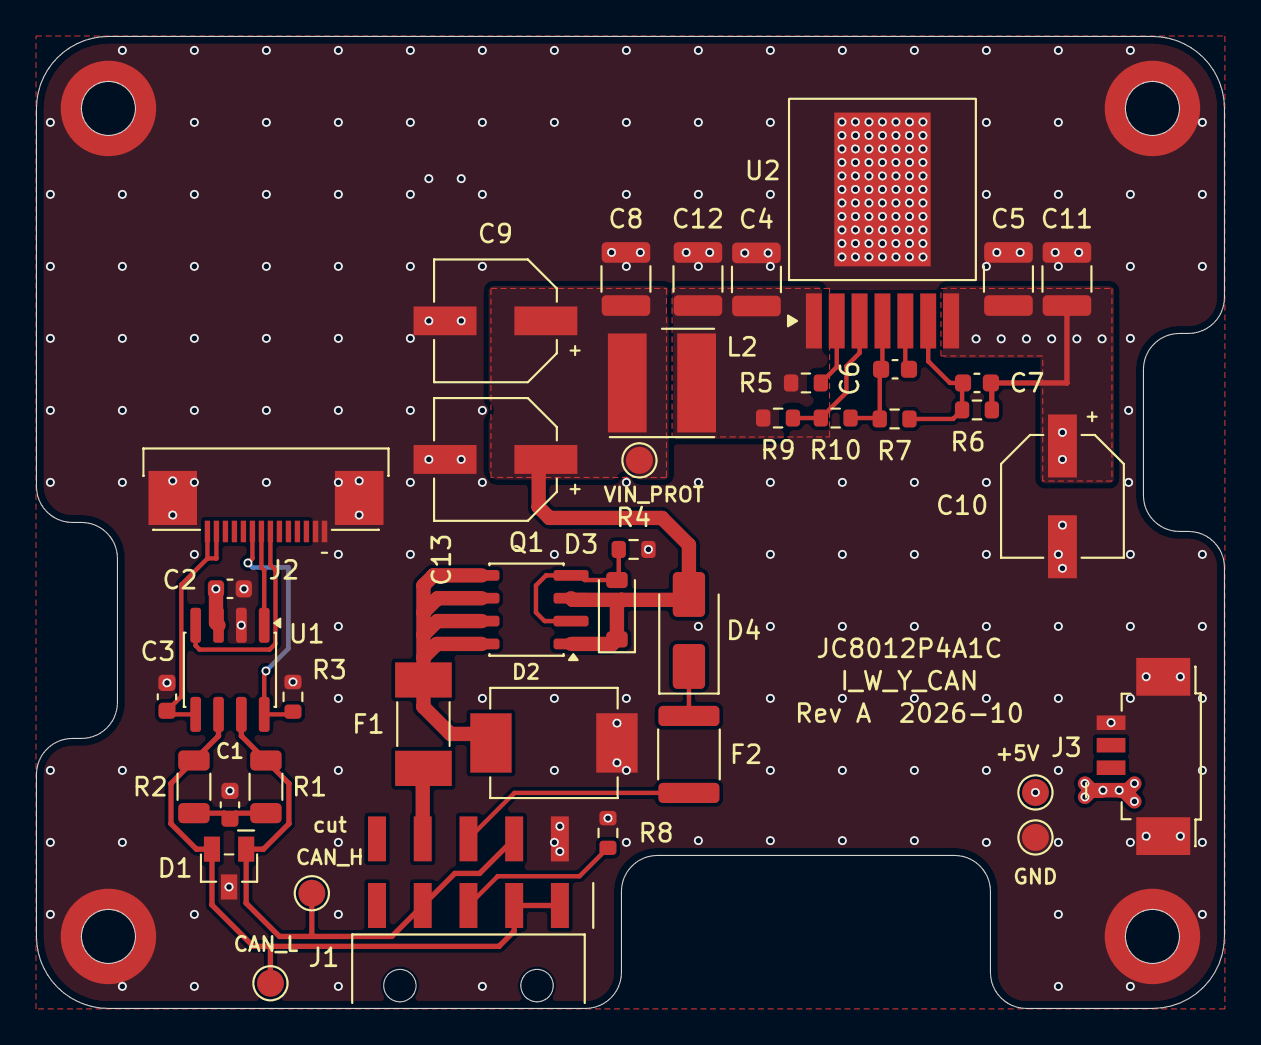
[picture p61: board JC8012P4A1C_I_W_Y_CAN.kicad_pcb from above]

Board: 6 copper layers, 66.0 x 54.0 mm, 45 parts (0 on the bottom side), 22 nets.
