Meisterschulen-am-Ostbahnhof-Munchen/JC8012P4A1C_I_W_Y_CAN/pcbs/keypad/JC8012P4A1C_keypad.kicad_pcb

## KiCad design pcbs/keypad/JC8012P4A1C_keypad.kicad_pcb (2026-11-11)

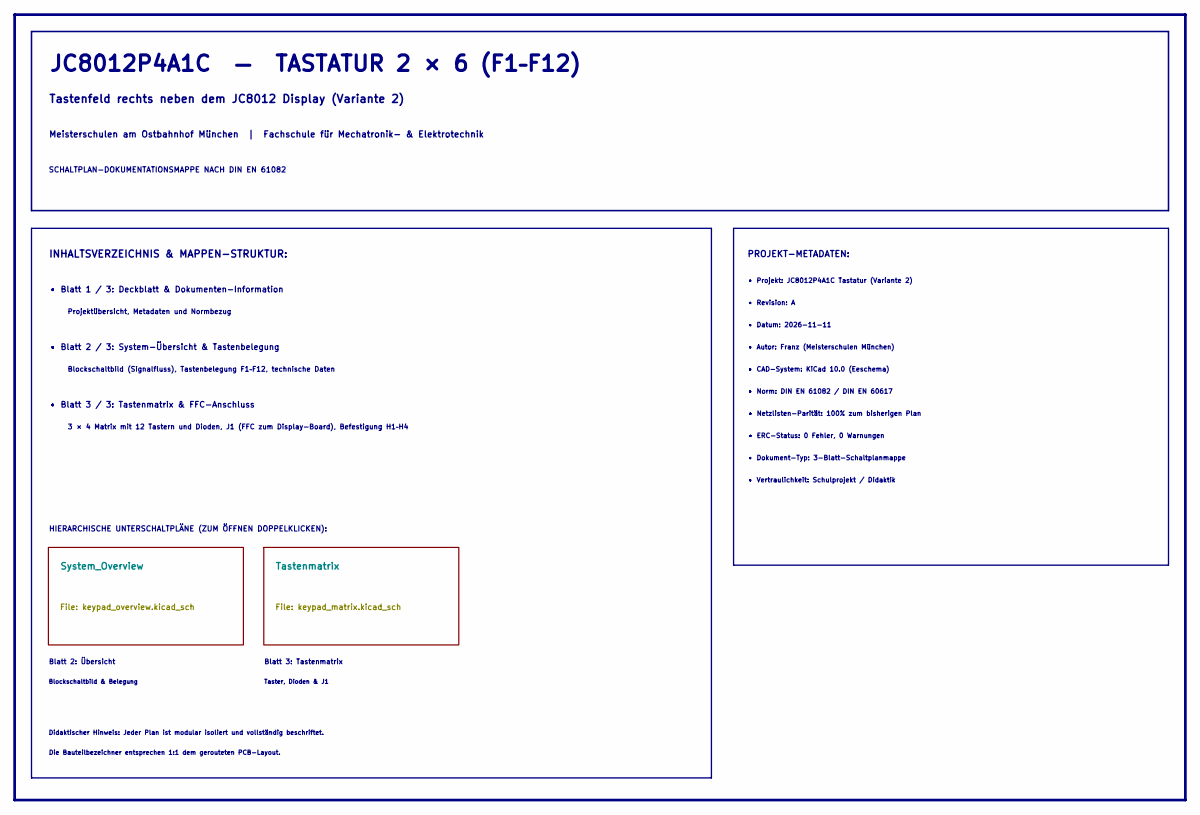
[picture p62: schematic JC8012P4A1C_keypad.kicad_sch, JC8012P4A1C — Tastatur 2 × 6]

Notes on the sheet:
SCHALTPLAN-DOKUMENTATIONSMAPPE NACH DIN EN 61082
Projektübersicht, Metadaten und Normbezug
• Norm: DIN EN 61082 / DIN EN 60617
Didaktischer Hinweis: Jeder Plan ist modular isoliert und vollständig beschriftet.
• Blatt 3 / 3: Tastenmatrix & FFC-Anschluss
• Netzlisten-Parität: 100% zum bisherigen Plan
• Datum: 2026-11-11
Blatt 2: Übersicht
Blockschaltbild (Signalfluss), Tastenbelegung F1–F12, technische Daten
JC8012P4A1C — TASTATUR 2 × 6 (F1–F12)
• Revision: A
Blockschaltbild & Belegung
• Vertraulichkeit: Schulprojekt / Didaktik
• CAD-System: KiCad 10.0 (Eeschema)
PROJEKT-METADATEN:
• ERC-Status: 0 Fehler, 0 Warnungen
• Dokument-Typ: 3-Blatt-Schaltplanmappe
Tastenfeld rechts neben dem JC8012 Display (Variante 2)
• Projekt: JC8012P4A1C Tastatur (Variante 2)
• Autor: Franz (Meisterschulen München)
• Blatt 1 / 3: Deckblatt & Dokumenten-Information
Die Bauteilbezeichner entsprechen 1:1 dem gerouteten PCB-Layout.
• Blatt 2 / 3: System-Übersicht & Tastenbelegung
Blatt 3: Tastenmatrix
Meisterschulen am Ostbahnhof München | Fachschule für Mechatronik- & Elektrotechnik
HIERARCHISCHE UNTERSCHALTPLÄNE (ZUM ÖFFNEN DOPPELKLICKEN):
INHALTSVERZEICHNIS & MAPPEN-STRUKTUR:
3 × 4 Matrix mit 12 Tastern und Dioden, J1 (FFC zum Display-Board), Befestigung H1–H4
Taster, Dioden & J1

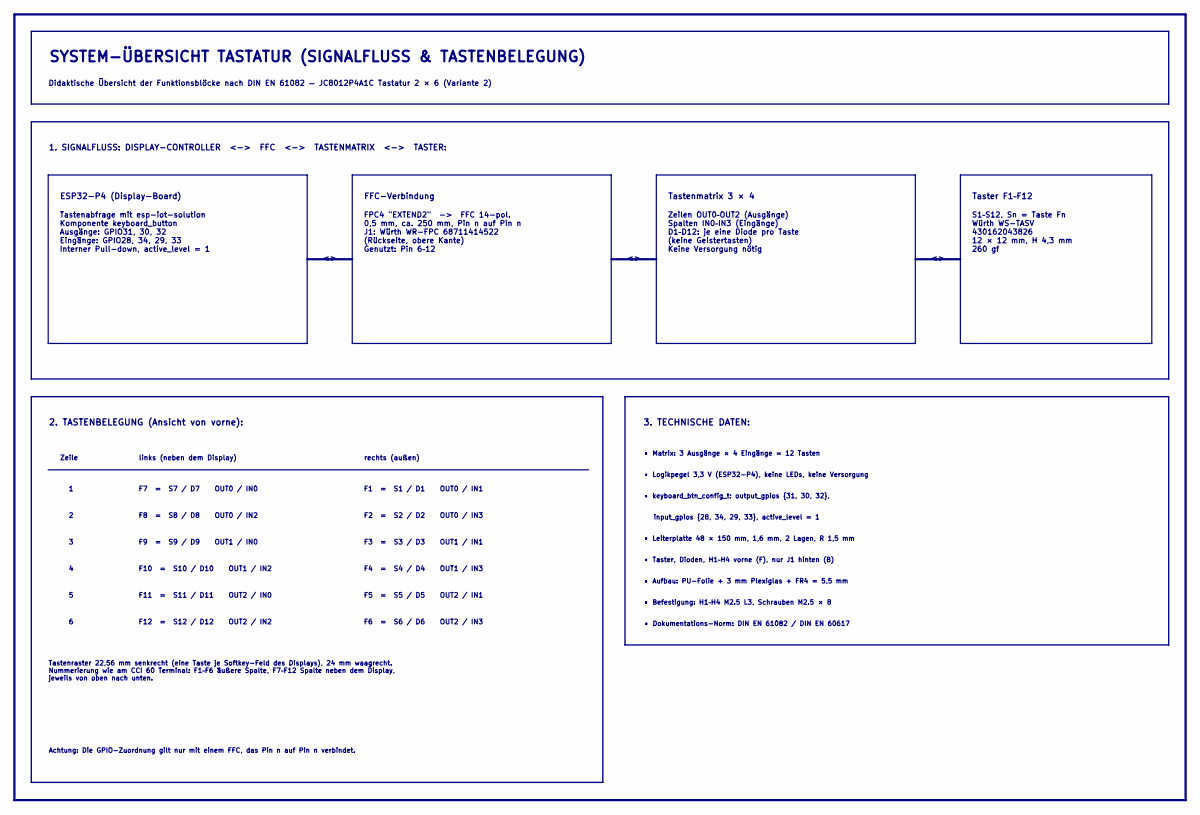
[picture p63: schematic keypad_overview.kicad_sch, JC8012P4A1C Tastatur — System-Übersicht]

Notes on the sheet:
• Befestigung: H1–H4 M2.5 L3, Schrauben M2.5 × 8
FPC4 "EXTEND2" -> FFC 14-pol. 0,5 mm, ca. 250 mm, Pin n auf Pin n J1: Würth WR-FPC 68711414522 (Rückseite, obere Kante) Genutzt: Pin 6–12
2. TASTENBELEGUNG (Ansicht von vorne):
F6 = S6 / D6 OUT2 / IN3
F3 = S3 / D3 OUT1 / IN1
Tastenraster 22,56 mm senkrecht (eine Taste je Softkey-Feld des Displays), 24 mm waagrecht. Nummerierung wie am CCI 60 Terminal: F1–F6 äußere Spalte, F7–F12 Spalte neben dem Display, jeweils von oben nach unten.
1. SIGNALFLUSS: DISPLAY-CONTROLLER <-> FFC <-> TASTENMATRIX <-> TASTER:
• keyboard_btn_config_t: output_gpios {31, 30, 32},
• Logikpegel 3,3 V (ESP32-P4), keine LEDs, keine Versorgung
Zeilen OUT0–OUT2 (Ausgänge) Spalten IN0–IN3 (Eingänge) D1–D12: je eine Diode pro Taste (keine Geistertasten) Keine Versorgung nötig
F5 = S5 / D5 OUT2 / IN1
F11 = S11 / D11 OUT2 / IN0
F9 = S9 / D9 OUT1 / IN0
F1 = S1 / D1 OUT0 / IN1
links (neben dem Display)
S1–S12, Sn = Taste Fn Würth WS-TASV 430162043826 12 × 12 mm, H 4,3 mm 260 gf
F12 = S12 / D12 OUT2 / IN2
Zeile
FFC-Verbindung
F4 = S4 / D4 OUT1 / IN3
• Leiterplatte 48 × 150 mm, 1,6 mm, 2 Lagen, R 1,5 mm
• Aufbau: PU-Folie + 3 mm Plexiglas + FR4 = 5,5 mm
F8 = S8 / D8 OUT0 / IN2
• Taster, Dioden, H1–H4 vorne (F), nur J1 hinten (B)
Achtung: Die GPIO-Zuordnung gilt nur mit einem FFC, das Pin n auf Pin n verbindet.
F2 = S2 / D2 OUT0 / IN3
Tastenmatrix 3 × 4
3. TECHNISCHE DATEN:
rechts (außen)
SYSTEM-ÜBERSICHT TASTATUR (SIGNALFLUSS & TASTENBELEGUNG)
• Matrix: 3 Ausgänge × 4 Eingänge = 12 Tasten
input_gpios {28, 34, 29, 33}, active_level = 1
Tastenabfrage mit esp-iot-solution Komponente keyboard_button Ausgänge: GPIO31, 30, 32 Eingänge: GPIO28, 34, 29, 33 Interner Pull-down, active_level = 1
F10 = S10 / D10 OUT1 / IN2
• Dokumentations-Norm: DIN EN 61082 / DIN EN 60617
Didaktische Übersicht der Funktionsblöcke nach DIN EN 61082 — JC8012P4A1C Tastatur 2 × 6 (Variante 2)
F7 = S7 / D7 OUT0 / IN0
Taster F1–F12
ESP32-P4 (Display-Board)

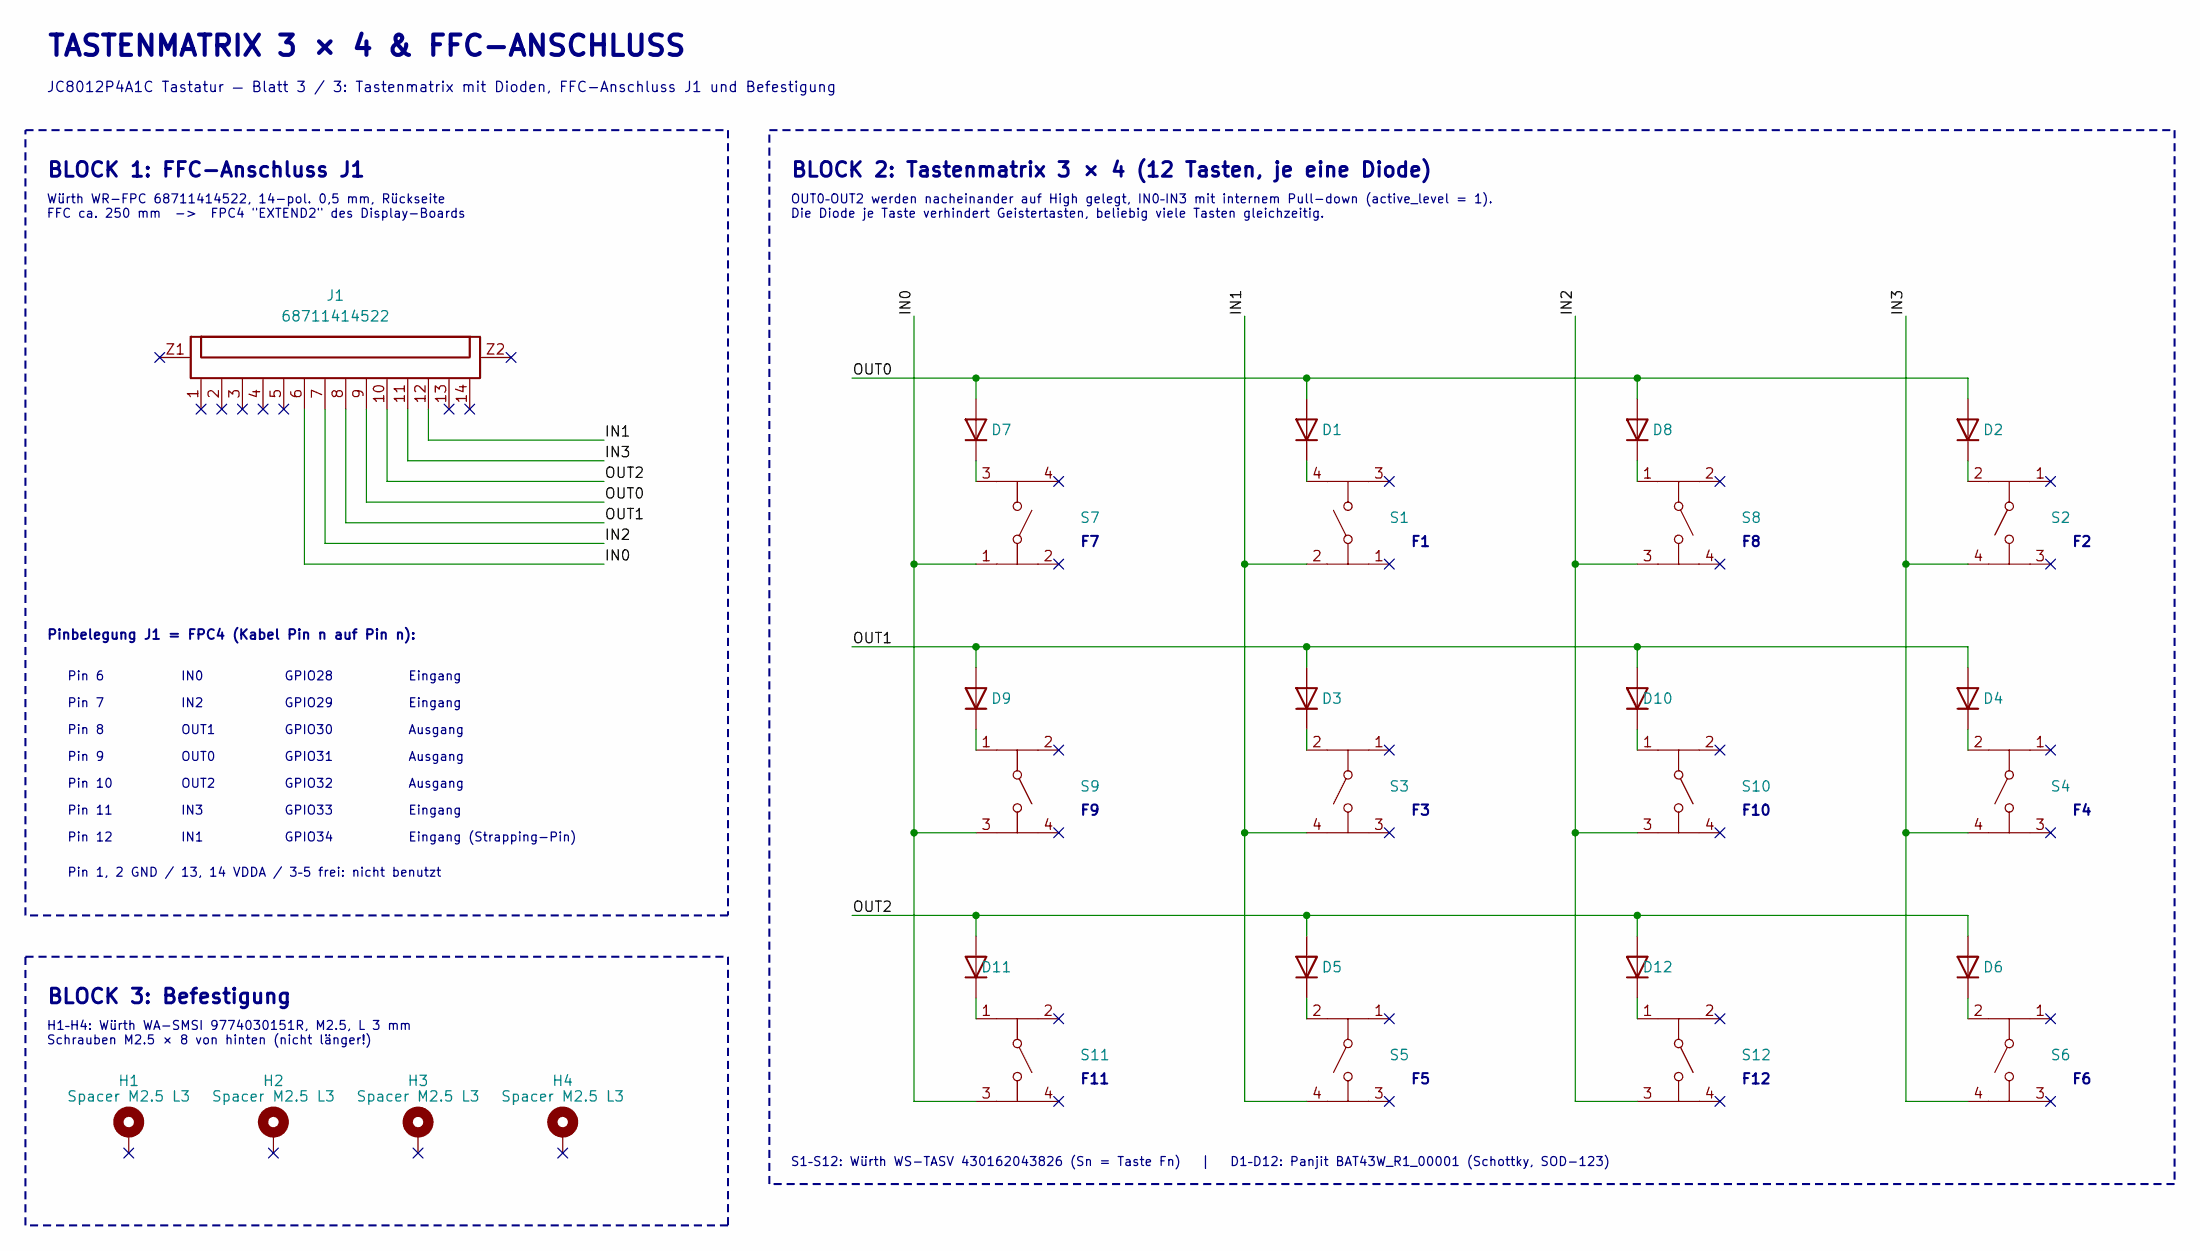
[picture p64: schematic keypad_matrix.kicad_sch, JC8012P4A1C Tastatur — Tastenmatrix & FFC]

Parts:
D1, D2, D3, D4, D5, D6, D7, D8, D9, D10, D11, D12: BAT43W; D_SOD-123; MPN BAT43W_R1_00001
H1, H2, H3, H4: Spacer M2.5 L3; A_Wurth_WA-SMSI_9774030151R; MPN 9774030151R
J1: 68711414522; J_Wurth_WR-FPC_68711414522; MPN 68711414522
S1, S2, S3, S4, S5, S6, S7, S8, S9, S10, S11, S12: 430162043826; SW_Wurth_WS-TASV_430162043826; MPN 430162043826

Connections:
/Tastenmatrix/IN0: J1.6, S7.1, S9.3, S11.3
/Tastenmatrix/IN1: J1.12, S1.2, S3.4, S5.4
/Tastenmatrix/IN2: J1.7, S8.3, S10.3, S12.3
/Tastenmatrix/IN3: J1.11, S2.4, S4.4, S6.4
/Tastenmatrix/OUT0: D1.2 (A), D2.2 (A), D7.2 (A), D8.2 (A), J1.9
/Tastenmatrix/OUT1: D3.2 (A), D4.2 (A), D9.2 (A), D10.2 (A), J1.8
/Tastenmatrix/OUT2: D5.2 (A), D6.2 (A), D11.2 (A), D12.2 (A), J1.10
unnamed: D1.1 (K), S1.4
unnamed: D2.1 (K), S2.2
unnamed: D3.1 (K), S3.2
unnamed: D4.1 (K), S4.2
unnamed: D5.1 (K), S5.2
unnamed: D6.1 (K), S6.2
unnamed: D7.1 (K), S7.3
unnamed: D8.1 (K), S8.1
unnamed: D9.1 (K), S9.1
unnamed: D10.1 (K), S10.1
unnamed: D11.1 (K), S11.1
unnamed: D12.1 (K), S12.1

Notes on the sheet:
GPIO29
Ausgang
BLOCK 2: Tastenmatrix 3 × 4 (12 Tasten, je eine Diode)
GPIO31
BLOCK 3: Befestigung
Pin 6
F10
OUT0
Pin 10
GPIO33
H1–H4: Würth WA-SMSI 9774030151R, M2.5, L 3 mm Schrauben M2.5 × 8 von hinten (nicht länger!)
Eingang (Strapping-Pin)
GPIO30
Eingang
GPIO32
GPIO28
IN1
Pin 12
OUT2
Pinbelegung J1 = FPC4 (Kabel Pin n auf Pin n):
Pin 8
GPIO34
F11
Pin 1, 2 GND / 13, 14 VDDA / 3–5 frei: nicht benutzt
BLOCK 1: FFC-Anschluss J1
Würth WR-FPC 68711414522, 14-pol. 0,5 mm, Rückseite FFC ca. 250 mm -> FPC4 "EXTEND2" des Display-Boards
IN3
IN2
Pin 9
Pin 11
Pin 7
OUT1
OUT0–OUT2 werden nacheinander auf High gelegt, IN0–IN3 mit internem Pull-down (active_level = 1). Die Diode je Taste verhindert Geistertasten, beliebig viele Tasten gleichzeitig.
IN0
JC8012P4A1C Tastatur — Blatt 3 / 3: Tastenmatrix mit Dioden, FFC-Anschluss J1 und Befestigung
TASTENMATRIX 3 × 4 & FFC-ANSCHLUSS
F12
S1–S12: Würth WS-TASV 430162043826 (Sn = Taste Fn) | D1–D12: Panjit BAT43W_R1_00001 (Schottky, SOD-123)

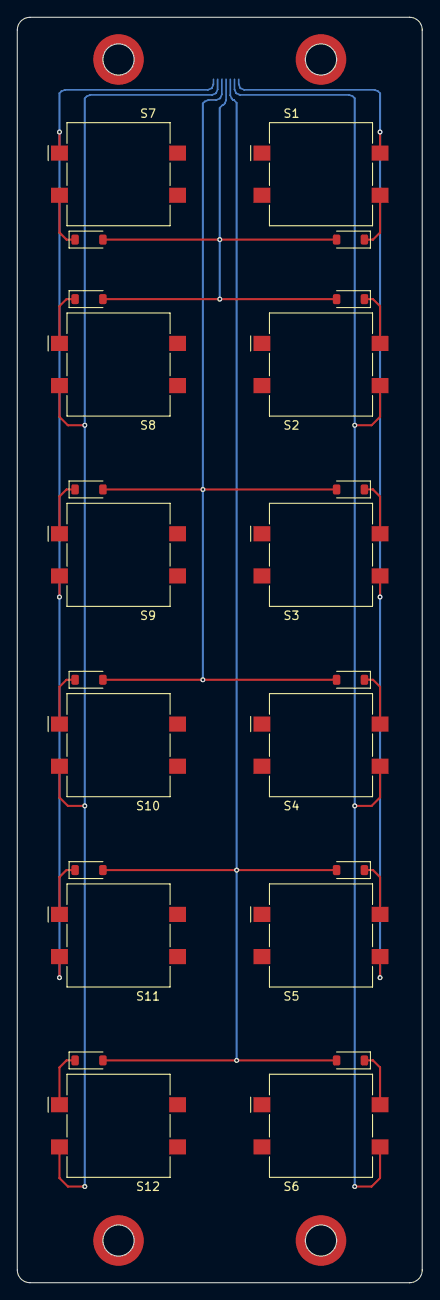
[picture p65: board JC8012P4A1C_keypad.kicad_pcb from above]

Board: 2 copper layers, 48.0 x 150.0 mm, 29 parts (1 on the bottom side), 19 nets.
