Meisterschulen-am-Ostbahnhof-Munchen/JC8012P4A1C_I_W_Y_CAN/(commit log)

2026-10-31 Add project-local KiCad library with Würth connectors
    Project-local symbol/footprint library JC8012P4A1C_CAN under lib/,
    registered via sym-lib-table/fp-lib-table using ${KIPRJMOD}.
    Contains only the two required Würth Elektronik parts:
    - WR-FPC 68711414522
    - WR-WTB 653104131822
    Footprint references and 3D model paths rewritten to the project
    library, files upgraded to KiCad 10 format. Würth disclaimer
    (CC BY-SA 4.0) included for attribution.
2026-10-31 Create KiCad 10 project JC8012P4A1C_I_W_Y_CAN
    Empty schematic and board created with KiCAD-MCP-Server v2.8.3.
    [JC8012P4A1C_I_W_Y_CAN.kicad_pcb, JC8012P4A1C_I_W_Y_CAN.kicad_sch]
2026-10-31 Add CAN transceiver and 12V->5V supply schematic
    CAN interface (ISOBUS, 250 kbit/s):
    - TLE9250VSJ transceiver, VCC 5 V, VIO 3.3 V from FPC3 VDDA
    - TXD/RXD on FPC3 pin 8/7 (GPIO4/GPIO5, as used by espVT)
    - NEN on FPC3 pin 9 (GPIO3) with 10k pull-down -> normal mode by default
    - Split termination 750R + 750R, 47 nF to GND (ECU Type I WEAK)
    - WE-TVS 824094024 on CAN_H/CAN_L
    - 10-pin box header 61201022921 -> ribbon -> IDC D-Sub 9 female
    618009221923, pinout of Mueller-Elektronik BASIC-Terminal CAN-ISO
    (fits adapter cable 481595 to In-Cab CPC-9)
    Power (12 V board net only):
    - Fuse 1 A slow, bidirectional TVS WE-TVSP 824551241 (SMDJ24CA)
    - Reverse polarity protection: dual P-MOSFET DMP6050SS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
    [JC8012P4A1C_I_W_Y_CAN.kicad_sch]
2026-10-31 Add TBC power output, mounting holes and board outline
    Schematic:
    - TBC_PWR_out on D-Sub pin 8 like the Mueller-Elektronik BASIC-Terminal
    (some harnesses do not start without powered terminators):
    VIN_PROT -> SS16 Schottky (no back-feed) -> PTC 0.14 A -> J1 pin 6
    - TBC_GND (D-Sub pin 3) to GND via R8 0R, DNP by default to stay
    compatible; fit R8 only if a harness needs the TBC_GND return
    - Mounting holes H1-H4, M2, 2.2 mm (ISO 273 medium)
    - Labels oriented away from pins, overlapping parts moved apart
    (netlist unchanged)
    Board:
    - Footprints imported from schematic (not placed yet)
    - Outline 66 x 54 mm (provisional), holes on 58 x 46 mm grid,
    4 mm from the edge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
    [JC8012P4A1C_I_W_Y_CAN.kicad_pcb, JC8012P4A1C_I_W_Y_CAN.kicad_sch]
2026-10-31 Plate mounting holes to GND, fix PCB footprint links, add README
    - H1-H4: MountingHole_Pad symbol, footprint MountingHole_2.2mm_M2_Pad_Via
    connected to GND (ground via the brass standoffs to the display
    board); excluded from BOM and position files
    - PCB re-imported with KiCad "Update PCB from Schematic" (F8):
    footprints now linked to their symbols, net names /GND etc.,
    R8 marked DNP. The earlier import via KiCAD-MCP-Server created
    unlinked footprints.
    - README: connectors, D-Sub 9 / J1 pinout, FPC3 pinout, termination,
    TBC power output and R8 (DNP by default, fit 0R if a harness needs
    the TBC_GND return), power section
    Cl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
    [JC8012P4A1C_I_W_Y_CAN.kicad_pcb, JC8012P4A1C_I_W_Y_CAN.kicad_sch]
2026-10-31 Board outline with notches, place FPC connector J2
    - Outline 66 x 54 mm, all corners R4: outer corners centred on the
    mounting holes, two notches (8 mm deep) for parts of the display
    board below: 100 uF electrolytic next to S4 (right edge) and the
    CR1220 RTC holder (bottom edge). Notch positions estimated from a
    photo, to be verified with a caliper.
    - J2 rotated 180 deg like FPC3 (opening towards the top edge, pin 1 on
    the right), x aligned with FPC3, 20 mm from the edge for a 50 mm FFC
    - README: FFC must be type B (opposite side contacts) because of the
    single 180 deg turn; pin 1 connects to pin 1
    Claude-Session: https://c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
    [JC8012P4A1C_I_W_Y_CAN.kicad_pcb]
2026-10-31 Third notch for CN5, R2 notch corners, move J2
    - New notch on the left edge for the 3x2 pin header CN5 of the display
    board (y 127-139, 4.5 mm deep)
    - Electrolytic notch moved down (y 116.5-127.5), CR1220 notch 8.5 mm deep
    (x 132.5-153); positions checked with a 1:1 paper template
    - All notch corners R2, outer corners R4 centred on the mounting holes
    - J2 moved 4 mm right (x 113) to clear the CN5 notch
    Claude-Session: https://claude.ai/code/session_014h8cGi8SRWthYdGFH1Qgzz
    [JC8012P4A1C_I_W_Y_CAN.kicad_pcb]
2026-10-31 J1: SMT right-angled pin header instead of THT box header
    - J1 is now Wuerth WR-PHD 610110249121 (2x5, 2.54 mm, SMT, right
    angled, 6.5 mm high). The former WR-BHD 61201022921 was a THT angled
    box header with long levers (32 x 28 mm) and too big; a straight SMT
    box header would be too high (only ~8 mm free under the cover).
    The board is now SMT only, all parts on the top side.
    - Same pinout, J1 rewired in the schematic (netlist checked)
    - J1 placed at the bottom edge left of the CR1220 notch, pins towards
    the edge (ribbon cable leaves downwards)
    - Polarisation without shroud: cut pin 10 and close position 10 of the
    IDC socket with a coding plug (pins 9/10 unused), see README
    - REA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
    [JC8012P4A1C_I_W_Y_CAN.kicad_pcb, JC8012P4A1C_I_W_Y_CAN.kicad_sch]
2026-10-31 J3 mounting tabs to GND, J1 flush with the board edge
    - J3 (WR-WTB 653104131822) symbol: added pins MP1/MP2 for the solder
    tabs of the footprint, connected to GND. Removes the two F8 warnings
    "no net for J3 pad MP1/MP2".
    - J1 moved so that the plastic body is flush with the bottom board
    edge; only the pins stick out, so the IDC socket can be plugged in.
    The two 1.8 mm locating holes are 0.37 mm from the routed edge
    (JLCPCB states no NPTH-to-edge rule; a broken web is harmless).
    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
    [JC8012P4A1C_I_W_Y_CAN.kicad_pcb, JC8012P4A1C_I_W_Y_CAN.kicad_sch]
2026-10-31 Power supply on its own sheet, EMI filter, UVLO, part numbers
    - New hierarchical sheet "Versorgung" (power.kicad_sch) with input
    protection, EMI filter, buck converter and TBC supply; connected to
    the main sheet by global labels ECU_PWR_IN, TBC_PWR_OUT, +5V, GND.
    Netlist checked: same parts and connections as before the split.
    - Input EMI filter as recommended in the 171030601 datasheet (p. 47,
    EN55022 class B): C8 1 uF (885012209047) + L2 10 uH WE-PD2 (74477410)
    - C9 47 uF/50 V SMD electrolytic (865080649013, D8 x 6.5 mm) damping
    the input, behind the reverse polarity protection
    - Second input MLCC C12 10 uF/50 V X7R (datasheet: >= 10 uF after
    derating), output C5/C11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
    [JC8012P4A1C_I_W_Y_CAN.kicad_pcb, JC8012P4A1C_I_W_Y_CAN.kicad_sch, power.kicad_sch]
2026-10-31 MPN and manufacturer fields for all Wuerth parts
    D1, D2, J1, J2, J3, U2: added MPN and Manufacturer; D2 also got its
    datasheet link (generic D_TVS symbol). All 19 Wuerth parts now carry
    MPN, manufacturer and datasheet link for the BOM.
    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
    [JC8012P4A1C_I_W_Y_CAN.kicad_sch, power.kicad_sch]
2026-10-31 Part numbers for all remaining parts, Q1 -> Si4948BEY
    - Resistors Yageo RC series 1 %. R1/R2 (split termination 750R) in
    1206 / 0.25 W: ISO 11783-2 asks for >= 125 mW for the termination
    resistors; worst case (CAN_H shorted to 24 V) is ~0.19 W each.
    - D3 onsemi MMSZ5245BT1G (15 V), D4 Diodes B160-13-F (60 V Schottky)
    - F1 Littelfuse 0452001.MRL NANO2 Slo-Blo 1 A / 125 V (1206 slow fuses
    are only rated 32-63 V), footprint changed to NANO2
    - F2 Bourns MF-MSMF014-2 (PTC 0.14 A / 60 V, 1812)
    - Q1 Vishay SI4948BEY-T1-E3 instead of the unavailable DMP6050SSD:
    dual P-ch 60 V, same SO-8 pinout (S1 G1 S2 G2 D2 D2 D1 D1), both
    halves in parallel (~60 mOhm)
    - U1 Infineon TLE9250VSJXUMA1
    - Eve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
    [JC8012P4A1C_I_W_Y_CAN.kicad_pcb, JC8012P4A1C_I_W_Y_CAN.kicad_sch, power.kicad_sch]
2026-10-31 Rough placement, buck converter per datasheet layout recommendation
    - CAN part on the left: U1 with C2/C3/R3, split termination R1/R2/C1,
    D1 and R8 next to J1
    - U2 placed as in the 171030601 layout recommendation (datasheet
    p. 39-44): pins pointing down, C_IN (C12, C4) vertical left of pin 1,
    C_OUT (C5, C11) vertical right of pin 7, GND pads in one row with the
    PGND pad, small parts in two rows below the pins
    (R5 C6 C7 / R9 R10 R7 R6)
    - EMI filter L2/C8 and damping capacitor C9 left of the converter,
    input chain F1 -> D2 -> Q1 (D3, R4) bottom centre, C10 at the output,
    TBC supply D4/F2 top centre, J3 at the right edge towards CN2
    - No courtyard overlaps; not routed yet
    Co-Auth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
    [JC8012P4A1C_I_W_Y_CAN.kicad_pcb]
2026-10-31 Refined placement (done in KiCad)
    - CAN group (U1, C2, C3, R3, R1/R2/C1, D1) between J2 and J1:
    CAN_H/CAN_L ~25 mm instead of ~57 mm, TXD/RXD/NEN 5-12 mm
    - F1 directly above J1 pin 8 (ECU_PWR_IN), D2/Q1/D3/R4 next to it
    - TBC supply D4/F2 next to Q1 and J1 (TBC_PWR_OUT 15 mm instead of 36)
    - C9 (6.5 mm high) moved out of the FFC path above J2
    - J2 4.35 mm closer to the top edge
    - Buck converter block per datasheet unchanged
    - DRC: no courtyard or clearance violations, schematic parity OK
    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
    [JC8012P4A1C_I_W_Y_CAN.kicad_pcb]
2026-10-31 6-layer stackup, planes, thermal vias under U2, net classes
    - 6 copper layers: F.Cu parts/signals, In1 GND, In2 +5V, In3 free for
    signals, In4 GND, B.Cu GND (JLCPCB 6-layer with epoxy filled and
    capped vias, same price as 2-layer with plugged vias)
    - GND zones on F.Cu/In1/In4/B.Cu, +5V zone on In2 (filled with
    kicad-cli; +5V plane still isolated until the first +5V vias exist)
    - 77 thermal vias 0.45/0.2 mm, 7 x 11 on a 0.75 mm grid under the U2
    exposed pad (171030601 datasheet p. 44: drill <= 250 um, 750 um
    pitch), intended as filled & capped (via-in-pad)
    - U2 EP and GND pads of C4/C12/C5/C11 solidly connected to the zones
    - Net classes: Power 0.8 mm / 0.25 mm (ECU_PWR_IN, ECU_PWR,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
    [JC8012P4A1C_I_W_Y_CAN.kicad_pcb]
2026-10-31 Separate BUCK_AGND net, no thermal reliefs for SMD pads
    - New local net BUCK_AGND on the power sheet: U2 pin 4 (AGND),
    C6 (C_SS), R7 (R_FBB), R10 (R_ENB). AGND is connected to PGND inside
    the 171030601; these grounds must be routed to the AGND pin only and
    not to the GND plane (datasheet p. 41). PWR_FLAG and a note added.
    - PCB pads updated accordingly (schematic parity OK)
    - All zones: pad connection "thermal reliefs for PTH only", i.e. all
    SMD pads solidly connected
    - Includes placement tweaks and the VIN_BUCK zone on F.Cu done in KiCad
    (C4/C12 closer to U2, L2, C8, C9 moved)
    Claude-Session: https://claude.ai/code/session_0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
    [JC8012P4A1C_I_W_Y_CAN.kicad_pcb, power.kicad_sch]
2026-10-31 Buck converter routing done in KiCad, +5V vias, C10 on the +5V zone
    - Converter routing (KiCad): RON, EN, SS, FB, AGND star to pin 4,
    VIN_BUCK zone and +5V zone on F.Cu, C10 rotated (+ towards VOUT)
    - 6 vias from the +5V zone to the In2 +5V plane, vias in C10+, J3 pin 1,
    C2 pin 1 and U1 pin 3 (+5V plane now connected)
    - 2 GND vias each in the GND pads of C4, C12, C5, C11
    - FB sense line C11+ -> R6/C7 reduced to 0.3 mm
    - +5V zone on F.Cu extended so that C10 (polymer) sits on the same
    copper as C5/C11 and U2 pin 7 (as on the evaluation board)
    - New +5V zone also "thermal reliefs for PTH only"
    - All vias 0.45/0.2 mm (epoxy filled & capped at JLCPCB)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
    [JC8012P4A1C_I_W_Y_CAN.kicad_pcb]
2026-10-31 J3 +5V pad: two vias instead of one
    Pin 1 of J3 carries the whole display current from the In2 +5V plane.
    Replace the single 0.45/0.2 via by two vias inside the pad.
    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
    [JC8012P4A1C_I_W_Y_CAN.kicad_pcb]
2026-10-31 GND vias in every SMD GND pad
    Outside the buck converter there was no GND via at all; the GND pads
    only reached the inner GND planes through the F.Cu pour and the
    mounting holes (25-50 mm). Add 27 vias 0.45/0.2: one per small pad,
    two per large pad (C8, C9, C10, D2, J1, J2 Z1/Z2, J3 MP1/MP2).
    J2 pins 1/2 are too narrow (0.3 mm) and use the Z1/Z2 vias.
    DRC: unconnected items 35 -> 0.
    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
    [JC8012P4A1C_I_W_Y_CAN.kicad_pcb]
2026-10-31 GND stitching, GND plane on In3, silkscreen cleanup
    - 155 GND stitching vias 0.45/0.2 on a 4 mm grid, only inside the GND
    pour, none in the mounting holes or in the VIN_PROT/VIN_BUCK pours
    - In3 was empty: GND pour on In3 (copper balance against the +5V plane
    on In2, one more GND plane)
    - Reference designators placed off pads, vias, courtyards and other
    silkscreen; J1 reference was outside the board. D2 and C1 use 0.8 mm
    text (0.15 mm stroke) for lack of space
    - J1 footprint: silkscreen rectangle replaced by a U-frame open towards
    the board edge (the housing is flush with the edge)
    DRC: 0 violations, 0 unconnected. ERC: 0.
    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
    [JC8012P4A1C_I_W_Y_CAN.kicad_pcb]
2026-10-31 Board marking, 3D images, README: PCB and manufacturing
    - Silkscreen: project name, Rev A 2026-10; "cut" mark at J1 pin 10
    - docs/: 3D renders (top and isometric) from kicad-cli pcb render
    - README: layer stack, via-in-pad (epoxy filled and capped), stitching,
    how to generate Gerber and drill files
    - production/ (generated outputs) ignored
    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
    [JC8012P4A1C_I_W_Y_CAN.kicad_pcb]
2026-10-31 Test points TP1-TP5 in the schematic
    TP1 +5V, TP2 GND, TP3 CAN_H, TP4 CAN_L (main sheet), TP5 VIN_PROT
    (12 V after fuse and reverse polarity protection, power sheet).
    Footprint TestPoint_Pad_D1.5mm (SMD). Not yet on the PCB (F8).
    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
    [JC8012P4A1C_I_W_Y_CAN.kicad_sch, power.kicad_sch]
2026-10-31 Input bulk capacitor: 2 x 22 uF/50 V (6.3 x 5.5) instead of 47 uF (8 x 6.5)
    C9 and new C13: Wurth WCAP-ASLI 865080643008, 22 uF / 50 V, D6.3 x 5.5 mm,
    in parallel on VIN_PROT. Lower than the old 8 x 6.5 mm part. A standard
    electrolytic (not polymer) is kept on purpose: its ESR damps the input
    filter (L2 + ceramic caps) and hot-plug ringing.
    Footprint and 3D model from the Wurth KiCad library (rev26c).
    Not yet on the PCB (F8).
    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
    [power.kicad_sch]
2026-10-31 PCB: C9/C13 2 x 22 uF and test points TP1-TP5 placed and connected
    - C9 and C13 (6.3 x 5.5) stacked in the former C9 column, + towards the
    VIN_PROT side, kept out of the FFC path above J2. C13 + connected to
    C9 + with a 0.8 mm trace, two GND vias in each GND pad
    - TP1 +5V / TP2 GND next to J3 (TP1 with +5V via in pad), TP3 CAN_H /
    TP4 CAN_L on the CAN lines between D1 and J1, TP5 in the VIN_PROT pour
    - Test points show the net name on the silkscreen instead of TPx
    - Silkscreen texts re-placed (C9, C13, D1, "cut")
    - 3D images and README (test points) updated
    DRC: 0 violations, 0 unconnected, schematic parity OK.
    Claude-Session: ht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
    [JC8012P4A1C_I_W_Y_CAN.kicad_pcb]
2026-10-31 Test points excluded from BOM, README: hand assembly, stencil, BOM export
    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
    [JC8012P4A1C_I_W_Y_CAN.kicad_pcb, JC8012P4A1C_I_W_Y_CAN.kicad_sch, power.kicad_sch]
2026-11-01 Mounting holes H1-H4 replaced by SMD steel spacers Wurth 9774025943R (2.5 mm, M2x6)
    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
    [JC8012P4A1C_I_W_Y_CAN.kicad_pcb, JC8012P4A1C_I_W_Y_CAN.kicad_sch]
2026-11-01 Spacer H1-H4: datasheet land pattern with non-plated 3.0 mm hole, DRC rule for pad to own NPTH
    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
    [JC8012P4A1C_I_W_Y_CAN.kicad_pcb]
2026-11-01 Assembly BOM for the final assembly (screws, FFC, CAN cable, D-Sub jackposts)
    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
2026-11-01 Add assembly_bom.csv (was excluded by *.csv in .gitignore)
    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
    [assembly_bom.csv]
2026-11-01 Back plate: second KiCad project (bare FR4, VESA 100 M4 spacers, M3 holes to the frame)
    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
    [JC8012P4A1C_backplate.kicad_pcb, JC8012P4A1C_backplate.kicad_sch]
2026-11-01 Frame (CC BY-SA, based on thing:7208630): D-Sub cutout, bosses for the back plate, keyhole tabs removed; back plate holes matched to the frame
    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
    [JC8012P4A1C_backplate.kicad_pcb, frame.step, frame.stl, guition_mount-landscape.step]
2026-11-01 Frame: bosses for WUEPLAST 3x10 (EJOT PT rules), D-Sub moved to x=-7 with nut recesses, FreeCAD renderings with back plate and D-Sub; assembly BOM screws
    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
    [assembly_bom.csv, frame.step, frame.stl]
2026-11-01 Frame: pilot hole for the 3 mm plastic screws 2.4 mm
    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
    [assembly_bom.csv, frame.step, frame.stl]
2026-11-01 Frame: jackposts 94510000 in 6 x 1 mm counterbores (1 mm wall under the hex), cable notch closed, renderings with D-Sub and jackposts; remove __pycache__
    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
    [assembly_bom.csv, frame.step, frame.stl]
2026-11-01 Gerber, drill files and BOMs of the CAN board and the back plate in the repository; README: overview of the three BOMs
    Gerber/drill files only as zip in the repository
    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
    [JC8012P4A1C_I_W_Y_CAN_bom.csv, JC8012P4A1C_backplate_bom.csv]
2026-11-01 Move C13 for panelization, add 5 V cable parts to assembly BOM
    - C13 moved away from the top edge so J1 of the neighbouring board in a
    panel does not reach into it; TP5 moved to the free corner of the
    VIN_PROT pour, 2 GND vias in the C13 pad, silkscreen labels re-placed
    - renders and Gerber zip regenerated
    - assembly BOM: 2 x WR-WTB housing 653004113322 and 2 x pre-crimped wire
    653153128130 for the 5 V cable J3 to CN2
    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
    [JC8012P4A1C_I_W_Y_CAN.kicad_pcb, assembly_bom.csv]
2026-11-01 README: licence section, fix D-Sub MPN and TP5 position
    - licence overview: GPL-3.0 for the project, CC BY-SA 4.0 for the Wurth
    library files in lib/ and backplate/lib/ and the KiCad libraries,
    CC BY-SA for mechanics/
    - Wurth disclaimer also in backplate/lib/
    - J1 table: D-Sub 618009227221, TP5 position after the C13 move
    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
2026-11-01 Back plate: speaker mount for XHXDZ-2828
    - board-only footprint LS1: 4 x 2.7 mm on 23 x 23 mm (M2.5), 19 sound
    holes 2.0 mm, speaker on the inside next to the display cover on the
    CN3 side (frame +87/+30), checked in 3D against cover, frame and display
    - assembly BOM: speaker, 4 x M2.5x8, 4 x nut M2.5
    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
    [JC8012P4A1C_backplate.kicad_pcb, assembly_bom.csv]
2026-11-01 CAN board: vias 0.3/0.5 mm instead of 0.2/0.45 mm
    0.2 mm drills cost extra at JLCPCB; the vias are filled and capped, so
    the size does not matter for soldering. 6 stitching vias moved 0.1 mm
    away from the board edge, 1 stitching via next to C13 removed. Net class
    via defaults updated. DRC clean, Gerber zip and renders regenerated.
    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
    [JC8012P4A1C_I_W_Y_CAN.kicad_pcb]
2026-11-01 Add Mouser order list (all non-Wurth parts of the CAN board)
    Quantities for 5 devices plus spares. TLE9250VSJXUMA1 is NRND at Mouser,
    stock is sufficient for this batch.
    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
    [mouser_order.csv]
2026-11-01 Add interactive HTML BOMs for hand assembly
    InteractiveHtmlBom for the CAN board and the back plate: pin 1 marked,
    checklists "Gelötet" and "Kontrolliert", DNP from the KiCad attribute.
    README: section with the command, Mouser list in the BOM table.
    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
2026-11-03 Variant 2 with keypad, assembly drawings for both variants
    Keypad (keypad/):
    - 12 keys Wurth WS-TASV 430162043826, 2 x 6, numbered F1-F12 as on the
    CCI 60 (F1-F6 outer column, F7-F12 next to the display)
    - 3 x 4 matrix with SOD-123 diodes on GPIO28-34 via FPC4 EXTEND2
    (esp-iot-solution keyboard_button), J1 WR-FPC on the back
    - M2.5 SMD spacers WA-SMSI 9774030151R, screwed from behind
    - 2 layers, tracks with 45 degree corners; ERC/DRC clean
    - Folika drawing: foil print in the style of FO SON PU 005 and
    plexiglass cut with pockets and diode notches (PDF 1:1, DXF)
    - Gerber zip, BOM, iBOM
    Mechanics:
    - frame_keypad: chamber on +x (seen from the front), foil 2 mm behind
    the glass plane, l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
    [D-Sub_Wurth_618009227221.step, JC8012P4A1C_backplate_keypad.kicad_pcb, JC8012P4A1C_backplate_keypad.kicad_sch, JC8012P4A1C_backplate_keypad_bom.csv, JC8012P4A1C_keypad.kicad_pcb, JC8012P4A1C_keypad.kicad_sch, JC8012P4A1C_keypad_bom.csv, JC8012P4A1_envelope.step]
2026-11-03 Assembly drawings: plexiglass and foil with R 1.5 corners like the PCB
    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
2026-11-10 Restructure repository: move PCBs to pcbs/ and assembly to top-level
    [D-Sub_Wurth_618009227221.step, JC8012P4A1C_I_W_Y_CAN.kicad_pcb, JC8012P4A1C_I_W_Y_CAN.kicad_sch, JC8012P4A1C_I_W_Y_CAN_bom.csv, JC8012P4A1C_backplate.kicad_pcb, JC8012P4A1C_backplate.kicad_sch, JC8012P4A1C_backplate_bom.csv, JC8012P4A1C_backplate_keypad.kicad_pcb]
2026-11-11 Merge pull request #2 from Meisterschulen-am-Ostbahnhof-Munchen/feature/clean-schematics
    Clean schematics: CAN board and keypad with cover sheets
    [JC8012P4A1C_I_W_Y_CAN.kicad_pcb, JC8012P4A1C_I_W_Y_CAN.kicad_sch, JC8012P4A1C_keypad.kicad_pcb, JC8012P4A1C_keypad.kicad_sch, JC8012P4A1C_keypad_bom.csv, can_bus.kicad_sch, keypad_matrix.kicad_sch, keypad_overview.kicad_sch]
2026-11-11 docs: GitHub Pages start page with links to BOMs, schematics, drawings (#3)
    - index.html: overview of all four PCBs (interactive BOM, schematic
    PDF, BOM CSV, Gerber), assembly drawings and the printed frames
    - .nojekyll: serve the files as they are
    - README: link to the Pages site
    Claude-Session: https://claude.ai/code/session_014h8cGf3Yf1RexPb88xHHK1
2026-11-13 Photo-like Blender renderings with the Folika foil print (#4)
    * feat(assembly): photo-like Blender renderings with the Folika foil print
    - render/make_textures.py: foil print cut from folika_keypad_12.pdf,
    espVT screen "GNSS / Teilbreiten" redrawn at 1280 x 800
    - make_assembly.py: ASSY_EXPORT=1 exports every part as STL in frame
    coordinates for the rendering
    - render/render_blender.py: Cycles rendering (PA12 frame, black glass,
    glowing screen, printed foil, studio lighting, shadow catcher),
    views front / keypad / back
    - img/render_variant*_*.png (1600 px) used in README and on the Pages
    start page
    - TODO: original Wurth 3D models for the screws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
2026-11-13 New stiffer frames and new D-Sub mounting (#5)
    * feat(mechanics): update frame and keypad CAD assemblies
    Regenerate the STEP and STL exports with the revised assembly structure, material data, and component geometry.
    * feat(mechanics): add frame and keypad CAD assemblies
    * feat(assembly): D-Sub 618009221923 with jackposts 94513200 and nuts 94505009
    New frames: 6 mm wall at the D-Sub with 5 mm hex pockets. Jackposts go in
    from outside (flush), the D-Sub without nuts from inside over the threads,
    WA-HEX nuts SW 4.5 from inside. Clamped length 4.76 mm, so 94510000 (thread
    5.0) is too short; 94513200 (thread 8.2) leaves 3.4 mm in the nut.
    D-Sub centre now z = 9.0. BOM pos. 3 and 7 changed, p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
    [D-Sub_Wurth_618009221923.step, D-Sub_Wurth_618009227221.step, HexNut_Wurth_94505009.step, Jackpost_Wurth_94513200.step, assembly_bom.csv, frame.f3d, frame.step, frame.stl]
2026-11-13 feat(assembly): whole assembly as STEP for both variants (#6)
    ASSY_STEP=1 freecad.exe make_assembly.py writes one STEP per variant, one
    named and coloured solid per part, not exploded. The WUEPLAST screws are
    always the simple model there (Wurth CAD data may not be passed on).
    Linked in the assembly README and on the Pages start page.
    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
    [JC8012P4A1C_assembly_variant1.step, JC8012P4A1C_assembly_variant2_keypad.step]
2026-11-13 D3 zener: Panjit MMSZ5245B_R1_00001 (#7)
    * fix(can_power): D3 zener Panjit MMSZ5245B_R1_00001 instead of onsemi MMSZ5245BT1G
    Same type (15 V, 500 mW, SOD-123), cheaper at Mouser. Footprint unchanged.
    * fix: Mouser part number 241-MMSZ5245BR100001 for D3
    ---------
    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
    [JC8012P4A1C_I_W_Y_CAN.kicad_pcb, JC8012P4A1C_I_W_Y_CAN_bom.csv, mouser_order.csv, mouser_reorder_32x.csv, power.kicad_sch]
